apws/261108-retro-comp-andrew-codex-kicad/schematics/02-wired-a3/README.adoc

= Separate wired A3 schematic
:title: {docname}

Open link:Z80_Simple_Computer.kicad_pro[the KiCad project] or link:../../output/pdf/Z80_Simple_Computer-wired-A3.pdf[the A3 PDF]. This is a separate single-sheet drawing of the checked circuit, with no PCB changes. The original label-oriented schematic remains authoritative in `design/`.

The address/data buses have 95 member entries. All 55 remaining scalar signal nets have continuous drawn paths; power uses standard supply symbols and wired local rails. See link:../../docs/261109-1528-SCHEMATIC-wired-A3.adoc[the handover and reproduction instructions].

The initial variant was generated by `tools/build_wired_schematic.py` and committed as `1184700`. Falken then refined it in KiCad. The current file is a verified *human-edited* schematic; continue editing this file directly. The generator retains its original output hash and refuses to overwrite the human edits. The layout snapshot synchronizer does not replace this separate drawing.

See link:../../docs/261109-1549-REVIEW-human-schematic-corrections.adoc[the human-corrections review and minimal wiring repairs]. After fresh native netlist/ERC exports, `tools/check_wired_schematic.py` rechecks the reviewed version. Its `--accept-manual` option records a newly edited version only after the connectivity, drawn-path and unchanged-rule checks pass.
