apws/261108-retro-comp-andrew-codex-kicad/reports/routing/03-kicad-interactive/route-worksheet.csv

group | net | reference | pad | x_mm | y_mm
group1 | /CLK | Y1 | 8 | 42.62 | 10.19
group1 | /CLK | U1 | 6 | 68.575 | 29.62
group1 | /CLK_UART | U5 | 16 | 51.025 | 41.38
group1 | /CLK_UART | Y2 | 5 | 41.81 | 25.19
group1 | /~{RESET} | U7 | 4 | 100.195 | 49.0
group1 | /~{RESET} | U1 | 26 | 91.435 | 14.38
group1 | /SW_RESET | R2 | 2 | 22.08 | 82.0
group1 | /SW_RESET | SW1 | 1 | 16.75 | 87.75
group1 | /SW_RESET | SW1 | 1 | 23.25 | 87.75
group1 | /RESET_RC | R2 | 1 | 11.92 | 82.0
group1 | /RESET_RC | C1 | 1 | 28.7487 | 78.0
group1 | /RESET_RC | R1 | 2 | 20.08 | 77.0
group1 | /RESET_RC | U7 | 1 | 100.195 | 41.38
group1 | /RESET_H | U5 | 35 | 76.425 | 56.62
group1 | /RESET_H | U7 | 2 | 100.195 | 43.92
group1 | /RESET_H | U7 | 3 | 100.195 | 46.46
group1 | /RESET_H | U4 | 35 | 68.575 | 70.38
group2 | /C1P | U6 | 1 | 23.805 | 58.89
group2 | /C1P | C20 | 1 | 28.7487 | 58.0
group2 | /C1M | U6 | 3 | 23.805 | 53.81
group2 | /C1M | C20 | 2 | 31.2487 | 58.0
group2 | /C2P | U6 | 4 | 23.805 | 51.27
group2 | /C2P | C21 | 1 | 28.7487 | 50.0
group2 | /C2M | U6 | 5 | 23.805 | 48.73
group2 | /C2M | C21 | 2 | 31.2487 | 50.0
group2 | /VS_MINUS | U6 | 6 | 23.805 | 46.19
group2 | /VS_MINUS | C24 | 2 | 28.7487 | 42.0
group2 | /VS_PLUS | U6 | 2 | 23.805 | 56.35
group2 | /VS_PLUS | C23 | 1 | 28.7487 | 66.0
group2 | /DSR_RS232 | J1 | 6 | 4.94 | 54.155
group2 | /DSR_RS232 | U6 | 8 | 23.805 | 41.11
group2 | /DTR_RS232 | J1 | 4 | 7.78 | 47.23
group2 | /DTR_RS232 | U6 | 7 | 23.805 | 43.65
group2 | /RX_RS232 | J1 | 2 | 7.78 | 52.77
group2 | /RX_RS232 | U6 | 13 | 16.185 | 51.27
group2 | /TX_RS232 | J1 | 3 | 7.78 | 50.0
group2 | /TX_RS232 | U6 | 14 | 16.185 | 53.81
group2 | /TX_TTL | U5 | 11 | 63.725 | 41.38
group2 | /TX_TTL | U6 | 11 | 16.185 | 46.19
group2 | /RX_TTL | U5 | 10 | 66.265 | 41.38
group2 | /RX_TTL | U6 | 12 | 16.185 | 48.73
group2 | /DTR_TTL | U5 | 33 | 71.345 | 56.62
group2 | /DTR_TTL | U6 | 10 | 16.185 | 43.65
group2 | /DSR_TTL | U5 | 37 | 81.505 | 56.62
group2 | /DSR_TTL | U6 | 9 | 16.185 | 41.11
group3 | /D0 | U5 | 1 | 89.125 | 41.38
group3 | /D0 | U4 | 34 | 71.115 | 70.38
group3 | /D0 | U1 | 14 | 88.895 | 29.62
group3 | /D0 | U2 | 11 | 138.89 | 56.62
group3 | /D0 | U3 | 11 | 138.89 | 29.62
group3 | /D1 | U5 | 2 | 86.585 | 41.38
group3 | /D1 | U4 | 33 | 73.655 | 70.38
group3 | /D1 | U1 | 15 | 91.435 | 29.62
group3 | /D1 | U2 | 12 | 141.43 | 56.62
group3 | /D1 | U3 | 12 | 141.43 | 29.62
group3 | /D2 | U5 | 3 | 84.045 | 41.38
group3 | /D2 | U4 | 32 | 76.195 | 70.38
group3 | /D2 | U1 | 12 | 83.815 | 29.62
group3 | /D2 | U2 | 13 | 143.97 | 56.62
group3 | /D2 | U3 | 13 | 143.97 | 29.62
group3 | /D3 | U5 | 4 | 81.505 | 41.38
group3 | /D3 | U4 | 31 | 78.735 | 70.38
group3 | /D3 | U1 | 8 | 73.655 | 29.62
group3 | /D3 | U2 | 15 | 146.51 | 41.38
group3 | /D3 | U3 | 15 | 146.51 | 14.38
group3 | /D4 | U5 | 5 | 78.965 | 41.38
group3 | /D4 | U4 | 30 | 81.275 | 70.38
group3 | /D4 | U1 | 7 | 71.115 | 29.62
group3 | /D4 | U2 | 16 | 143.97 | 41.38
group3 | /D4 | U3 | 16 | 143.97 | 14.38
group3 | /D5 | U5 | 6 | 76.425 | 41.38
group3 | /D5 | U4 | 29 | 83.815 | 70.38
group3 | /D5 | U1 | 9 | 76.195 | 29.62
group3 | /D5 | U2 | 17 | 141.43 | 41.38
group3 | /D5 | U3 | 17 | 141.43 | 14.38
group3 | /D6 | U5 | 7 | 73.885 | 41.38
group3 | /D6 | U4 | 28 | 86.355 | 70.38
group3 | /D6 | U1 | 10 | 78.735 | 29.62
group3 | /D6 | U2 | 18 | 138.89 | 41.38
group3 | /D6 | U3 | 18 | 138.89 | 14.38
group3 | /D7 | U5 | 8 | 71.345 | 41.38
group3 | /D7 | U4 | 27 | 88.895 | 70.38
group3 | /D7 | U1 | 13 | 86.355 | 29.62
group3 | /D7 | U2 | 19 | 136.35 | 41.38
group3 | /D7 | U3 | 19 | 136.35 | 14.38
group4 | /~{A15} | U7 | 8 | 107.815 | 56.62
group4 | /~{A15} | U8 | 13 | 122.815 | 72.92
group4 | /~{A7} | U7 | 6 | 100.195 | 54.08
group4 | /~{A7} | U8 | 5 | 115.195 | 80.54
group4 | /~{PIOCS} | U4 | 6 | 68.575 | 85.62
group4 | /~{PIOCS} | U8 | 3 | 115.195 | 75.46
group4 | /~{ROMCS} | U3 | 20 | 133.81 | 14.38
group4 | /~{ROMCS} | U8 | 8 | 122.815 | 85.62
group4 | /~{RAMCS} | U2 | 20 | 133.81 | 41.38
group4 | /~{RAMCS} | U8 | 11 | 122.815 | 78.0
group4 | /~{UARTCS} | U5 | 14 | 56.105 | 41.38
group4 | /~{UARTCS} | U8 | 6 | 115.195 | 83.08
group4 | /A0 | U5 | 28 | 58.645 | 56.62
group4 | /A0 | U4 | 9 | 76.195 | 85.62
group4 | /A0 | U1 | 30 | 81.275 | 14.38
group4 | /A0 | U2 | 10 | 136.35 | 56.62
group4 | /A0 | U3 | 10 | 136.35 | 29.62
group4 | /A1 | U5 | 27 | 56.105 | 56.62
group4 | /A1 | U4 | 8 | 73.655 | 85.62
group4 | /A1 | U1 | 31 | 78.735 | 14.38
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
group7 | /PC4 | U4 | 13 | 86.355 | 85.62
group7 | /PC4 | J4 | 5 | 82.27 | 94.0
group7 | /PC5 | U4 | 12 | 83.815 | 85.62
group7 | /PC5 | J4 | 6 | 84.81 | 94.0
group7 | /PC6 | U4 | 11 | 81.275 | 85.62
group7 | /PC6 | J4 | 7 | 87.35 | 94.0
group7 | /PC7 | U4 | 10 | 78.735 | 85.62
group7 | /PC7 | J4 | 8 | 89.89 | 94.0
