apws/261108-retro-comp-andrew-codex-kicad/output/firstz80/01-manhattan/placement.png

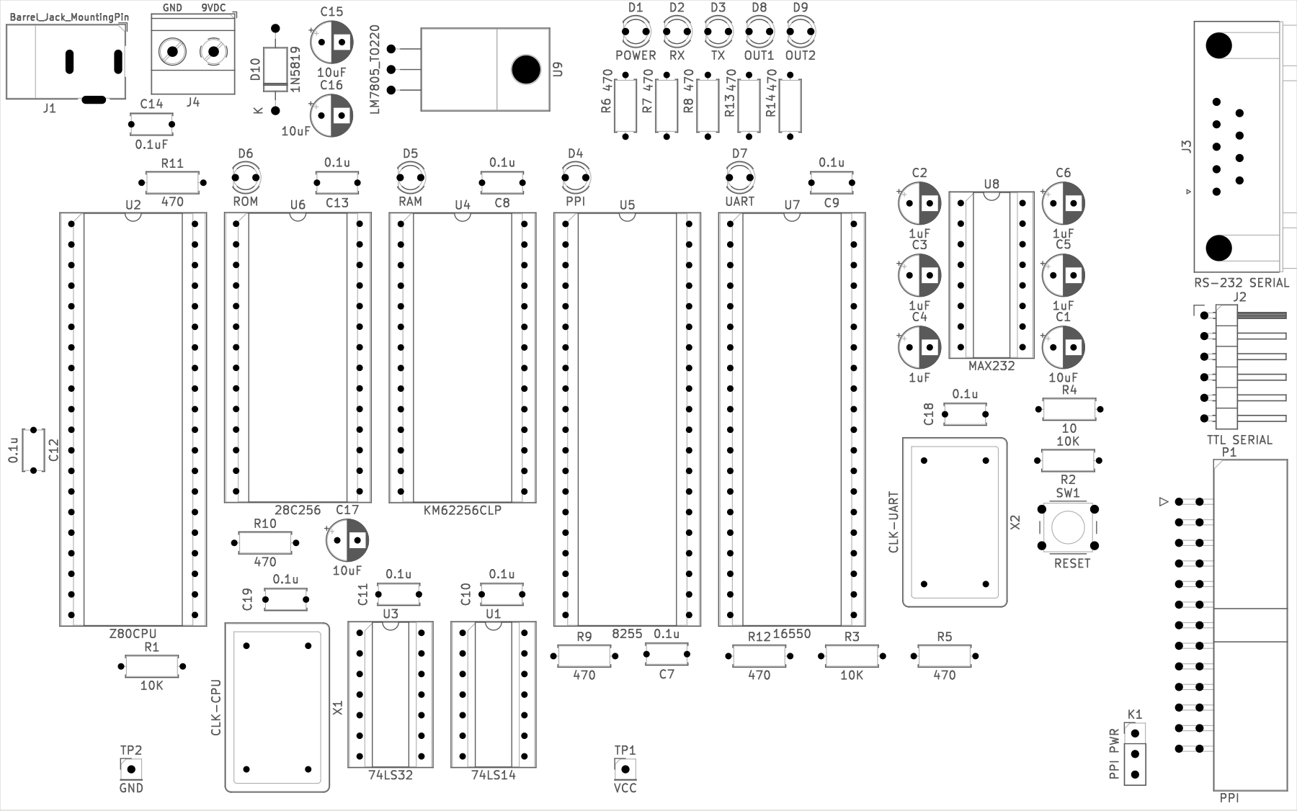
output/firstz80/01-manhattan/placement.png
