apws/261108-retro-comp-andrew-codex-kicad/output/firstz80/03-freerouting/signals.png

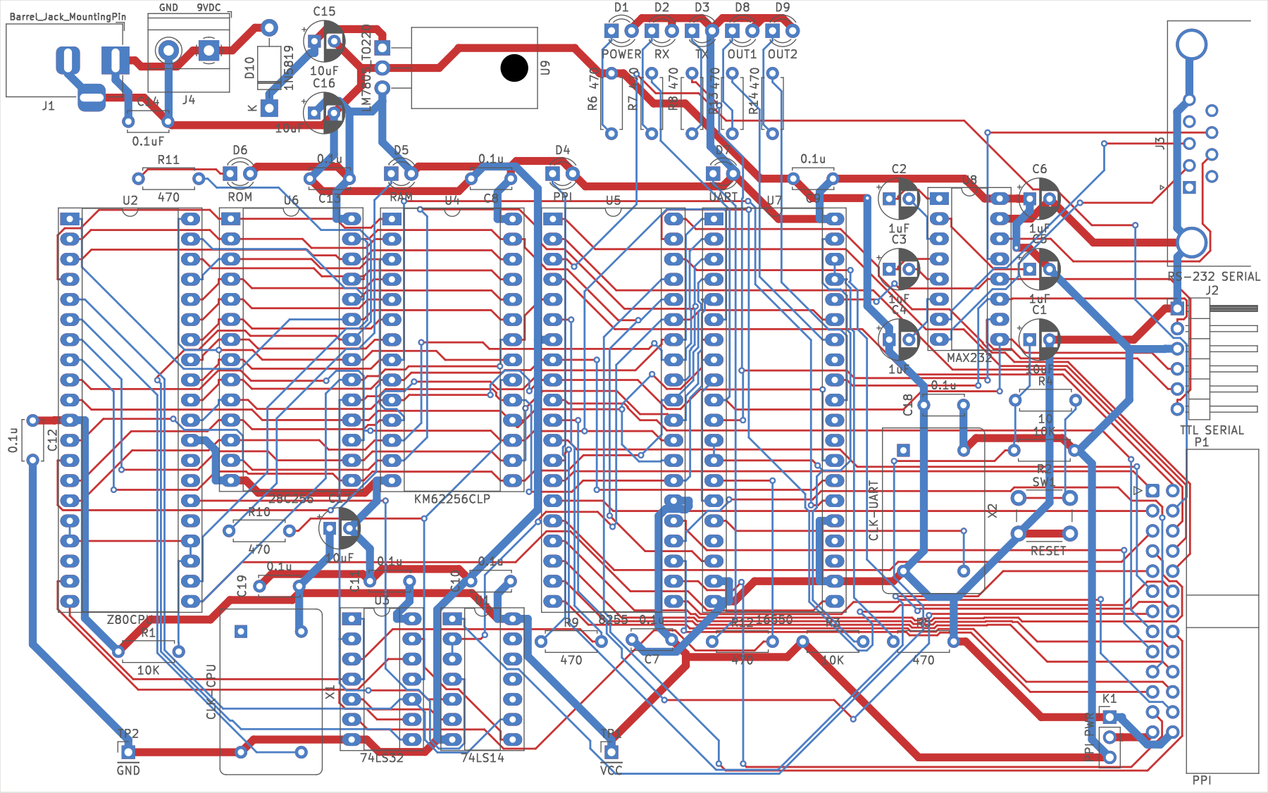
output/firstz80/03-freerouting/signals.png
