apws/261108-retro-comp-andrew-codex-kicad/output/firstz80/03-freerouting/top.png

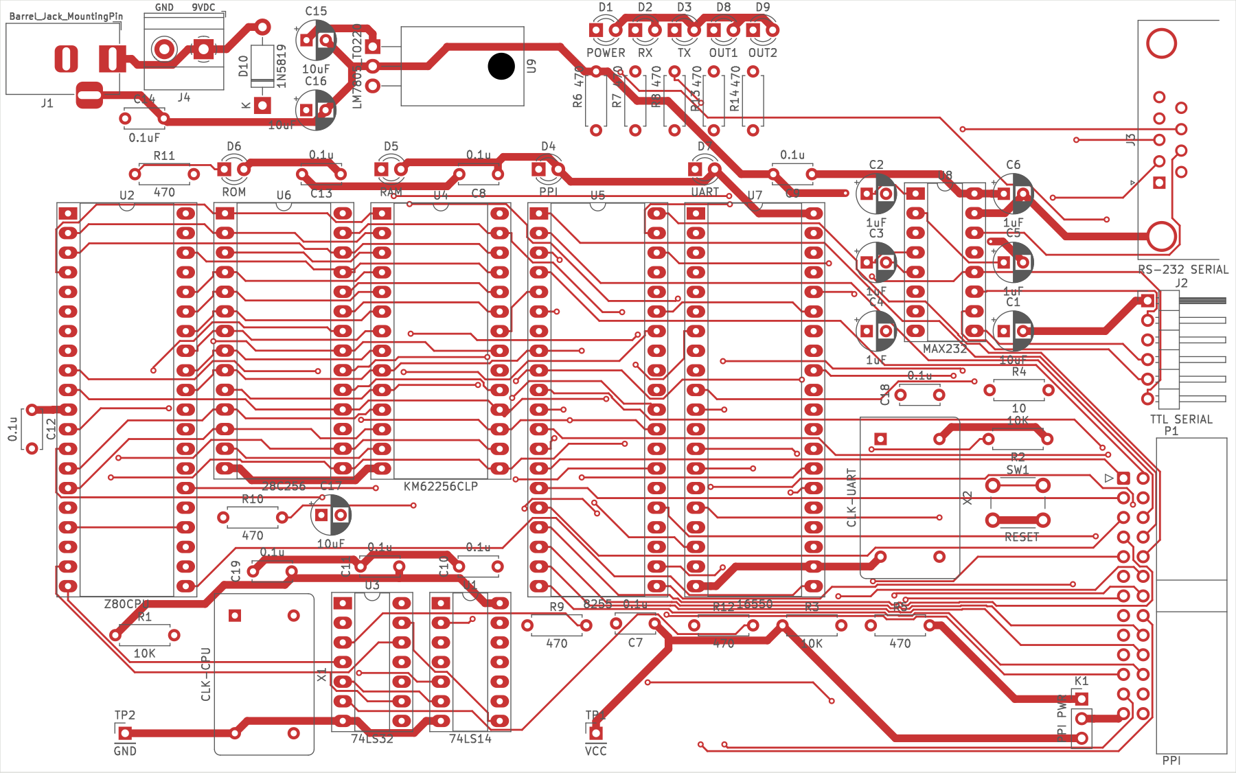
output/firstz80/03-freerouting/top.png
