apws/261108-retro-comp-andrew-codex-kicad/output/firstz80/comparison.png

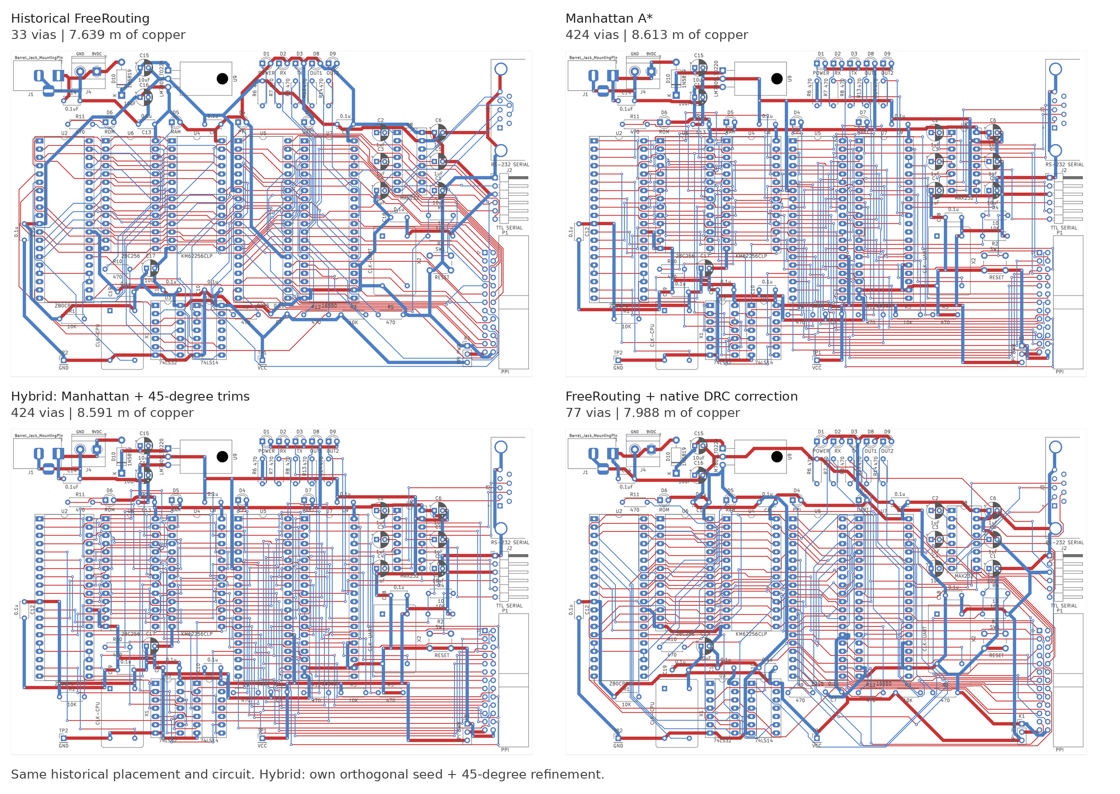
output/firstz80/comparison.png
