apws/261108-retro-comp-andrew-codex-kicad/output/firstz80/octilinear-corner-detail.png

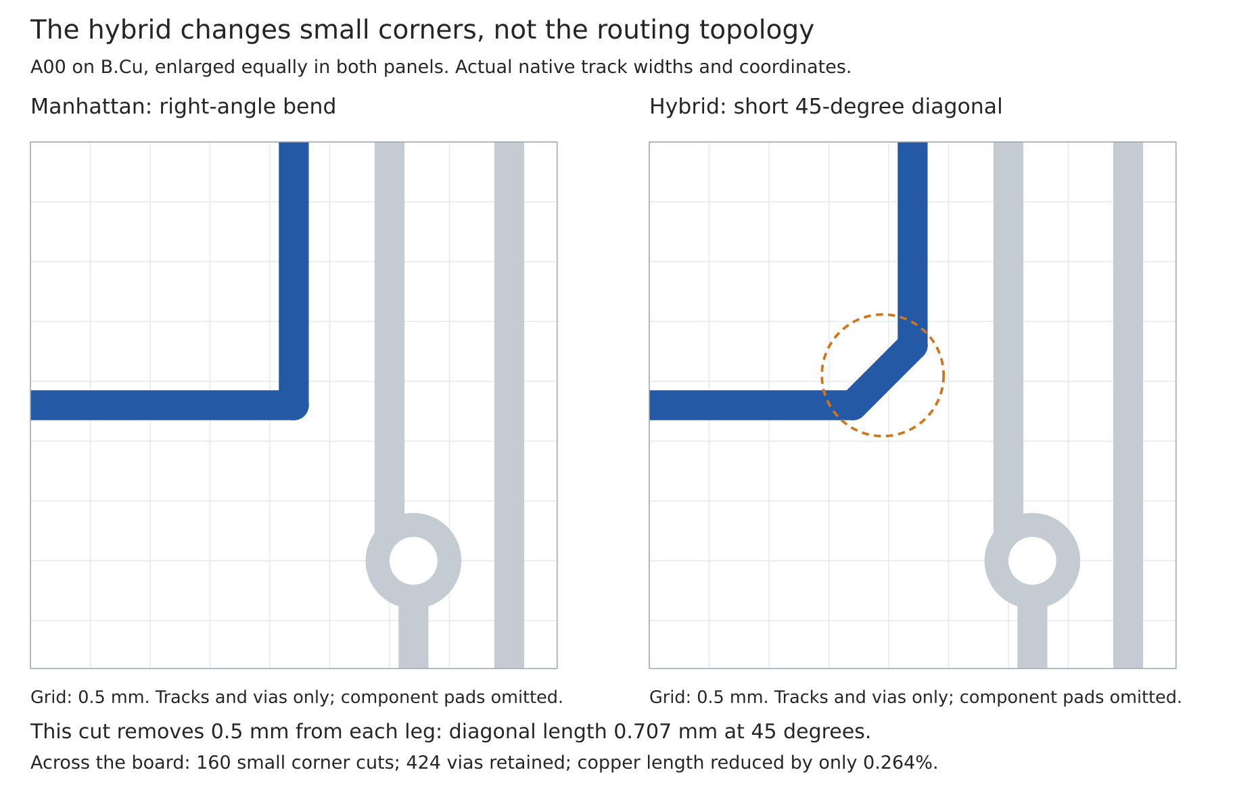
output/firstz80/octilinear-corner-detail.png
