apws/261108-retro-comp-andrew-codex-kicad/output/firstz80/reference-normalized/bottom.png

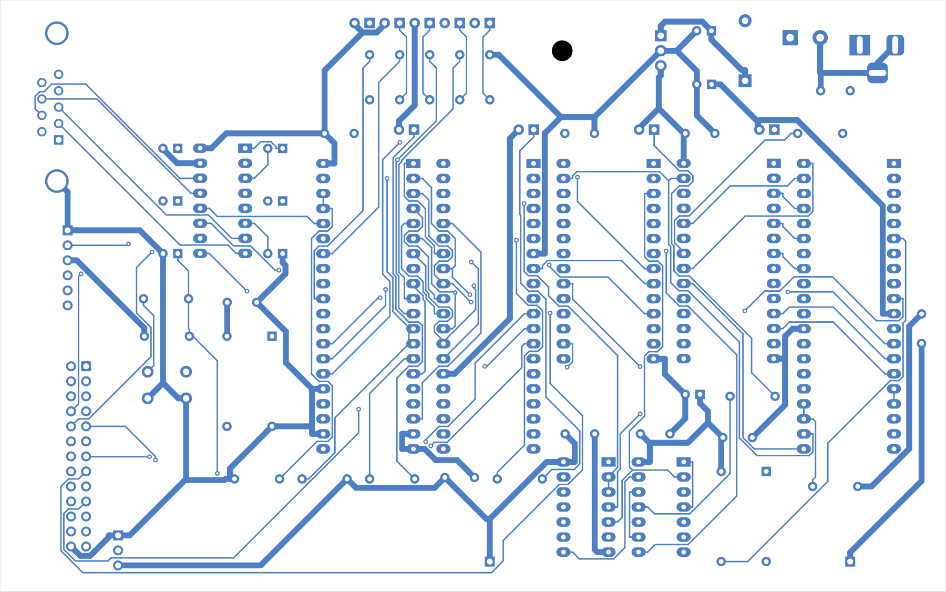
output/firstz80/reference-normalized/bottom.png
