apws/261108-retro-comp-andrew-codex-kicad/output/routing/01-reused-agy-router/top.png

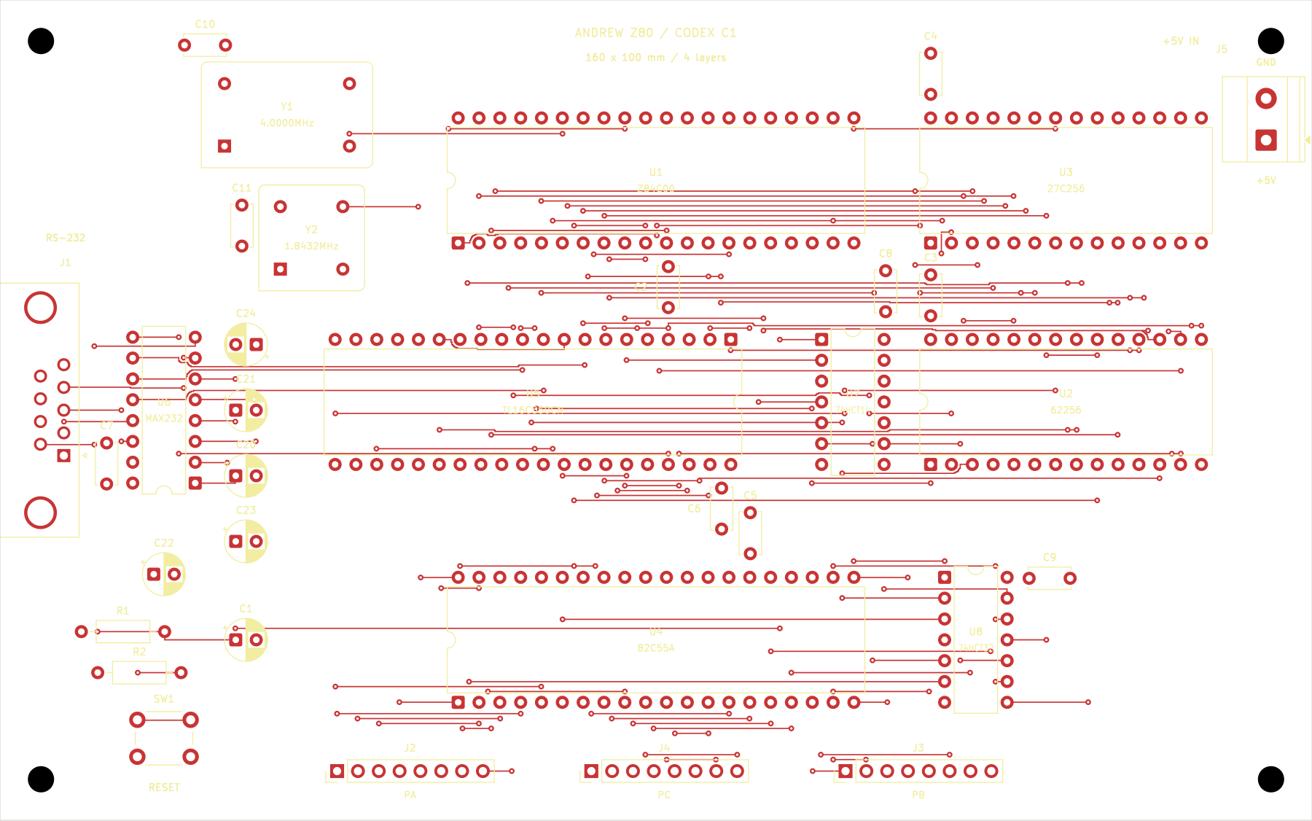
output/routing/01-reused-agy-router/top.png
