apws/261108-retro-comp-andrew-codex-kicad/output/routing/02-codex-router/bottom.png

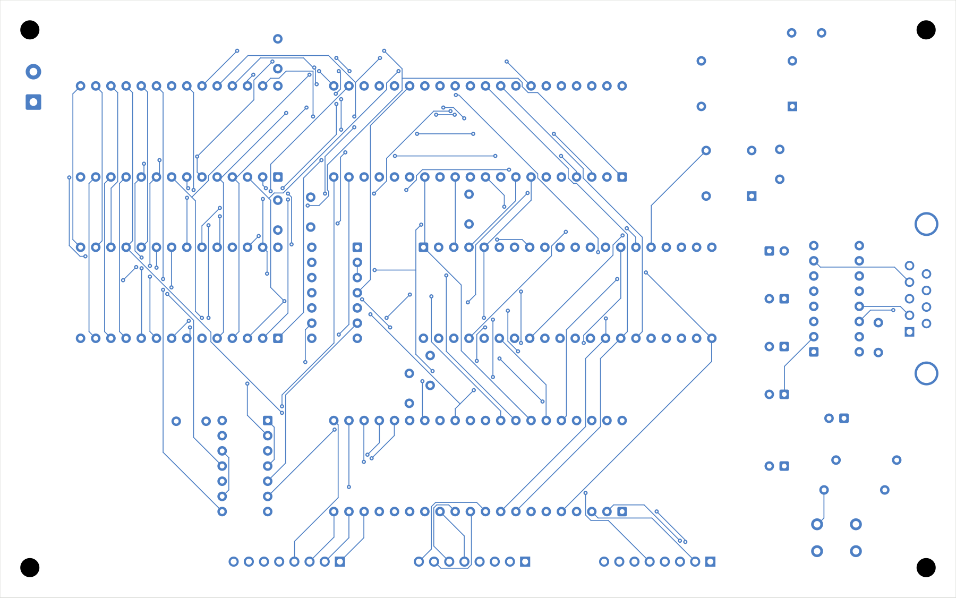
output/routing/02-codex-router/bottom.png
