apws/261108-retro-comp-andrew-codex-kicad/output/routing/02-codex-router/planes.png

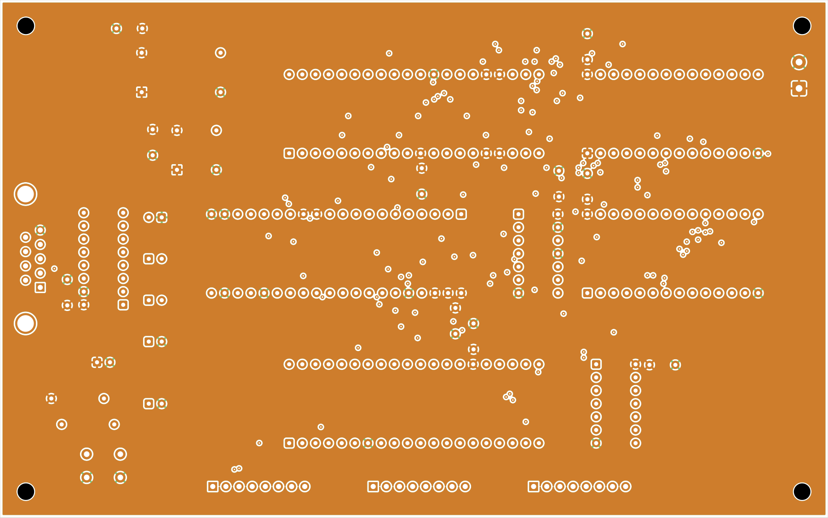
output/routing/02-codex-router/planes.png
