apws/261108-retro-comp-andrew-codex-kicad/output/routing/04-freerouting/bottom.png

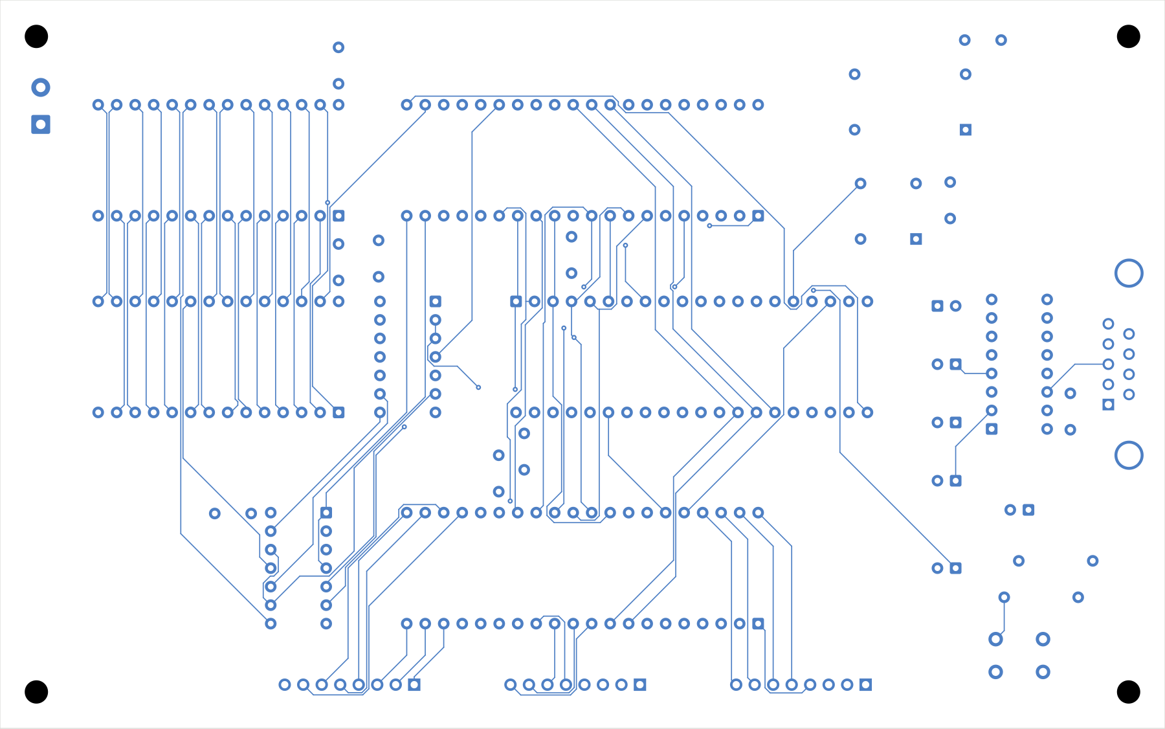
output/routing/04-freerouting/bottom.png
