apws/261108-retro-comp-andrew-codex-kicad/output/routing/04-freerouting/top.png

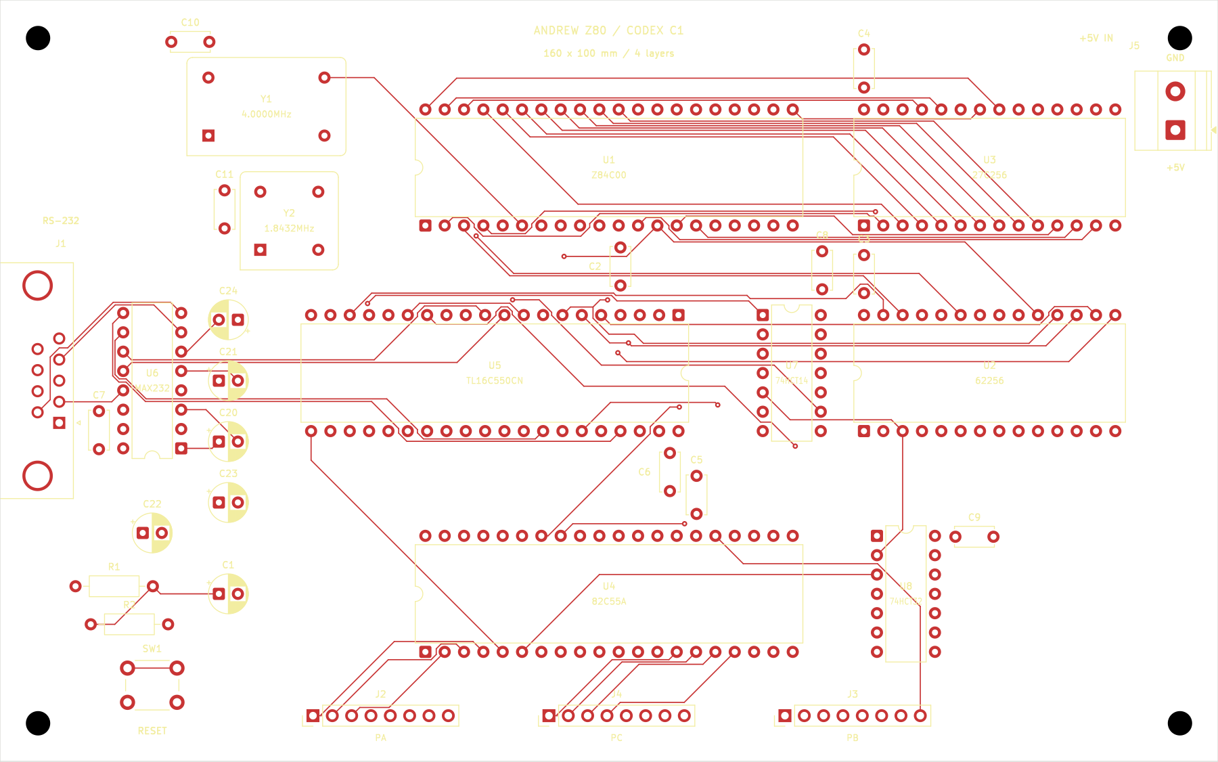
output/routing/04-freerouting/top.png
