apws/261108-retro-comp-andrew-codex-kicad/output/schematic-7805/schematic-7805.png

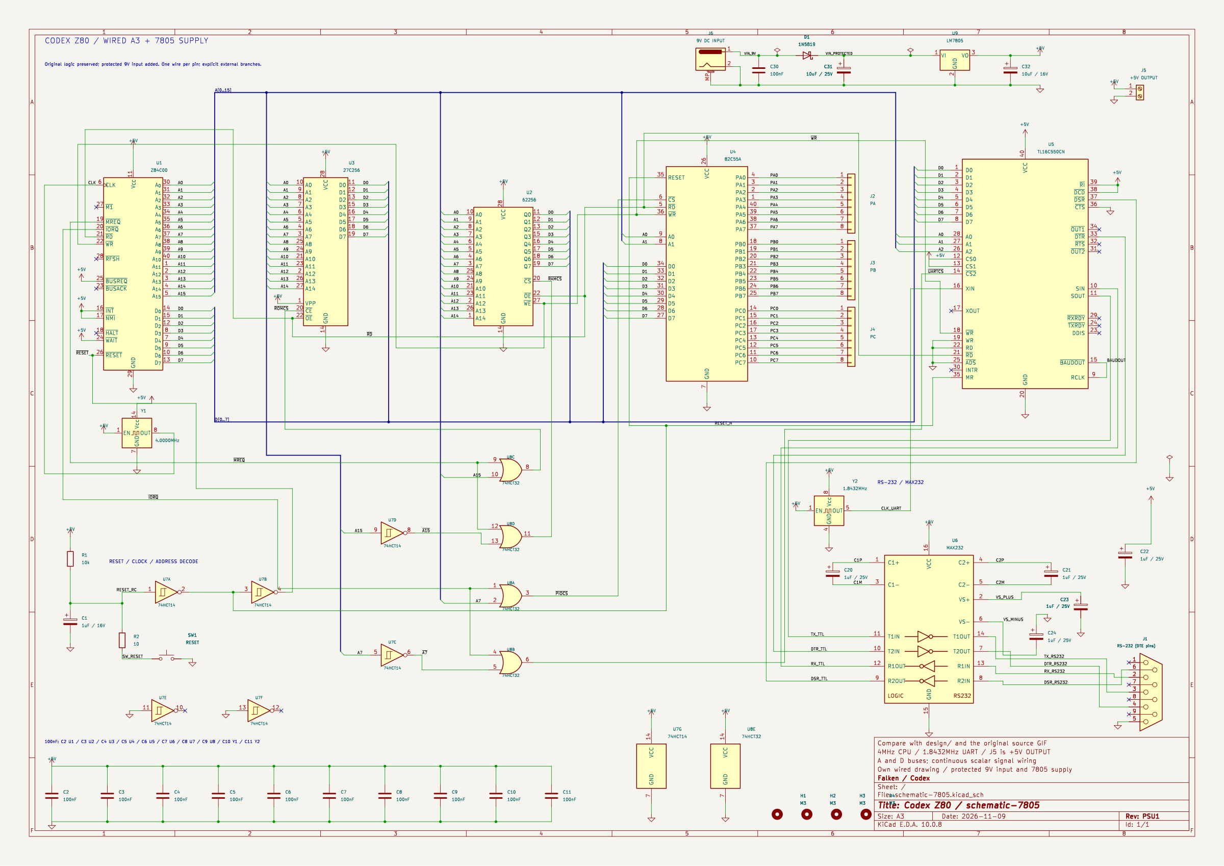
output/schematic-7805/schematic-7805.png
