apws/261108-retro-comp-andrew-codex-kicad/reference/grok-agy/docs/images/261103-2328 first schematic -- Screenshot_20261103_232820.png

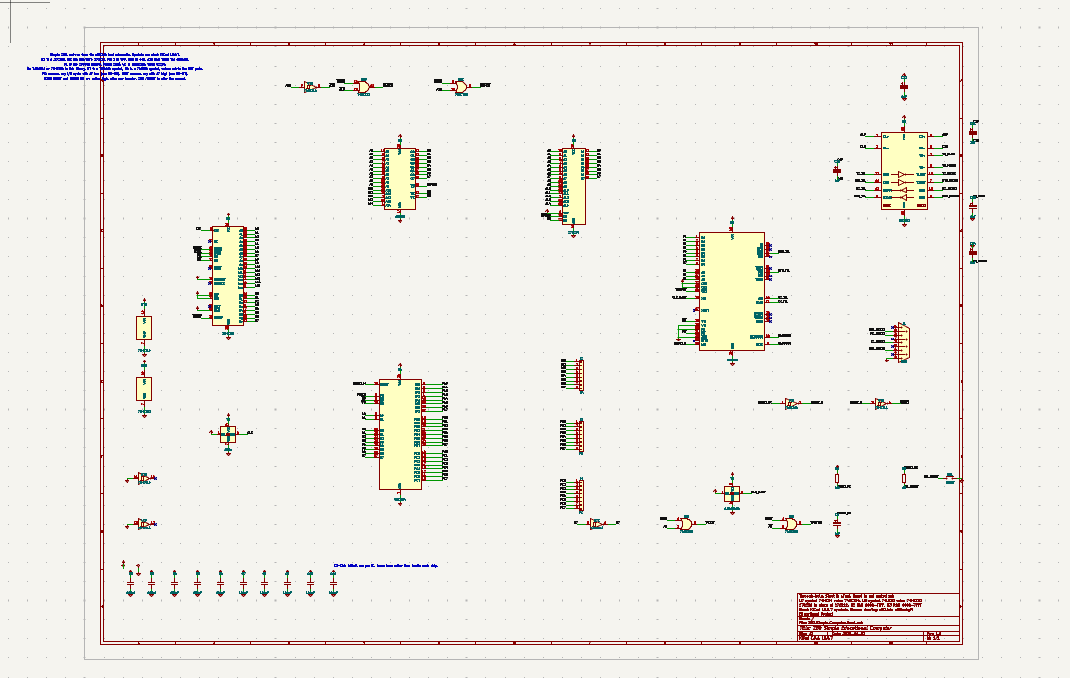
reference/grok-agy/docs/images/261103-2328 first schematic -- Screenshot_20261103_232820.png
