apws/261108-retro-comp-andrew-codex-kicad/reference/grok-agy/docs/images/261104-0004 very hard for grok only to relayout the sheet QQQ -- Screenshot_20261104_000429.png

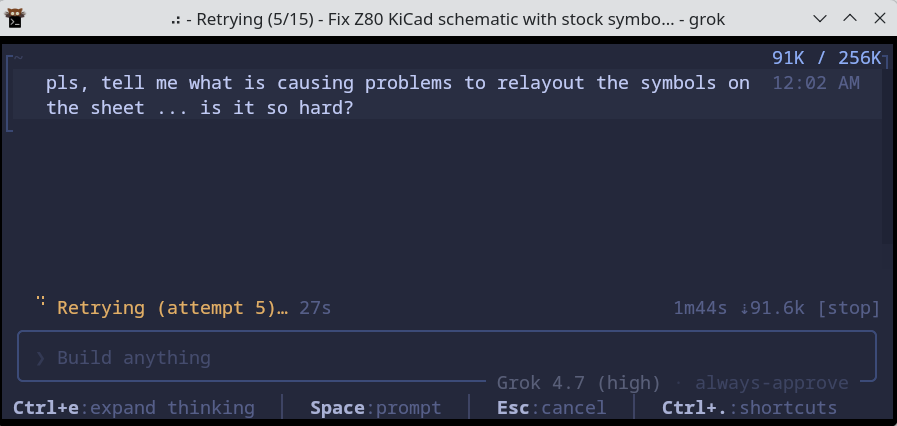
reference/grok-agy/docs/images/261104-0004 very hard for grok only to relayout the sheet QQQ -- Screenshot_20261104_000429.png
