apws/261108-retro-comp-andrew-codex-kicad/reference/grok-agy/docs/images/261104-0042 schematic relayout, but still large A2 sheet QQ -- Screenshot_20261104_004217.png

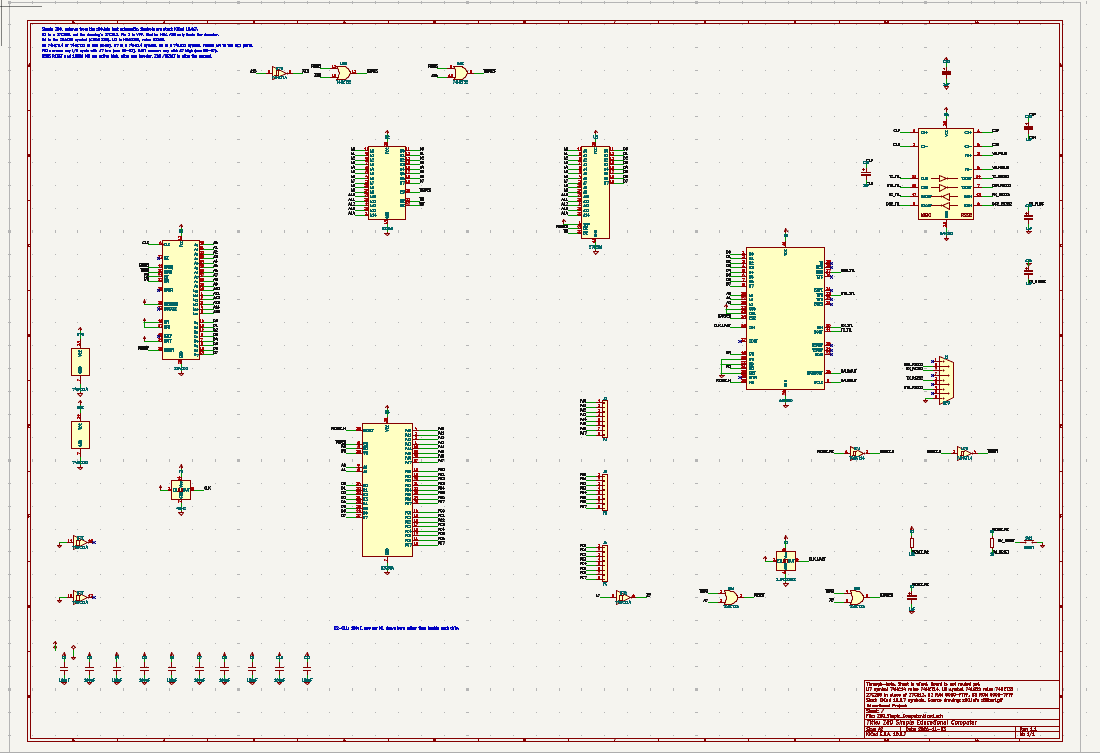
reference/grok-agy/docs/images/261104-0042 schematic relayout, but still large A2 sheet QQ -- Screenshot_20261104_004217.png
