apws/261108-retro-comp-andrew-codex-kicad/reference/grok-agy/docs/images/261105-00 implementing the placement and routing plan, it started but - out of weekly limit.png

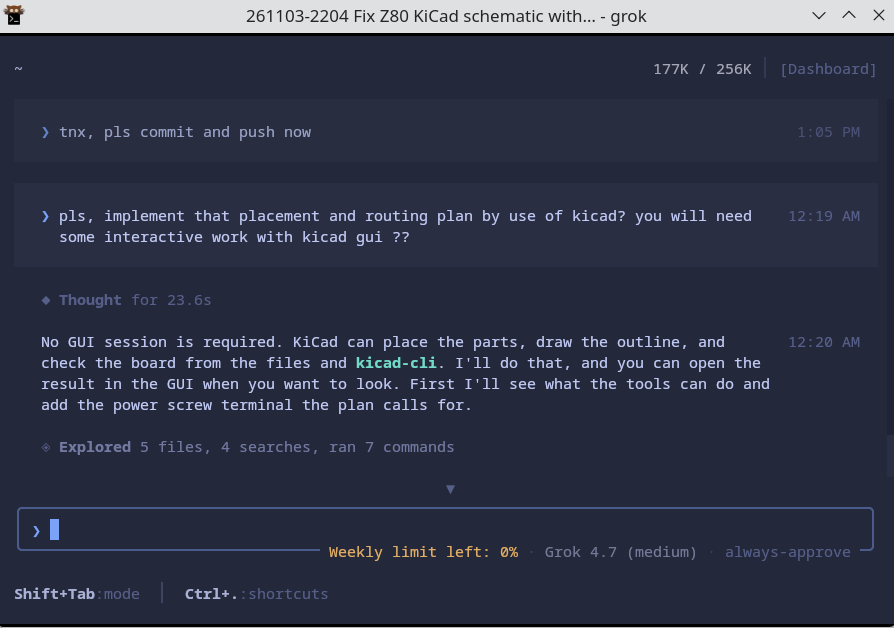
reference/grok-agy/docs/images/261105-00 implementing the placement and routing plan, it started but - out of weekly limit.png
