apws/261108-retro-comp-andrew-codex-kicad/reference/grok-agy/docs/images/261105-01 tell the agent - use tscircuit - Screenshot_20261105_011434.png

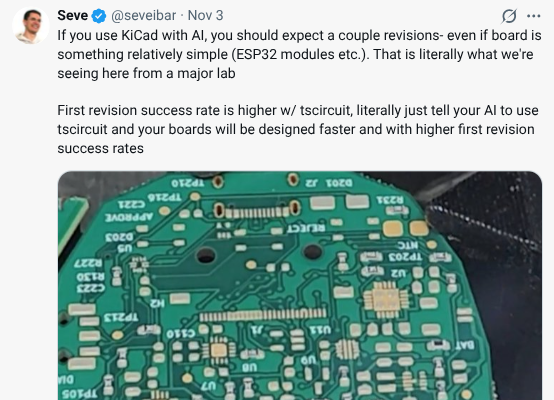
reference/grok-agy/docs/images/261105-01 tell the agent - use tscircuit - Screenshot_20261105_011434.png
