apws/261108-retro-comp-andrew-codex-kicad/reference/grok-agy/docs/images/261106-03 grok 2nd placement and 3d models in -- Screenshot_20261106_030632.png

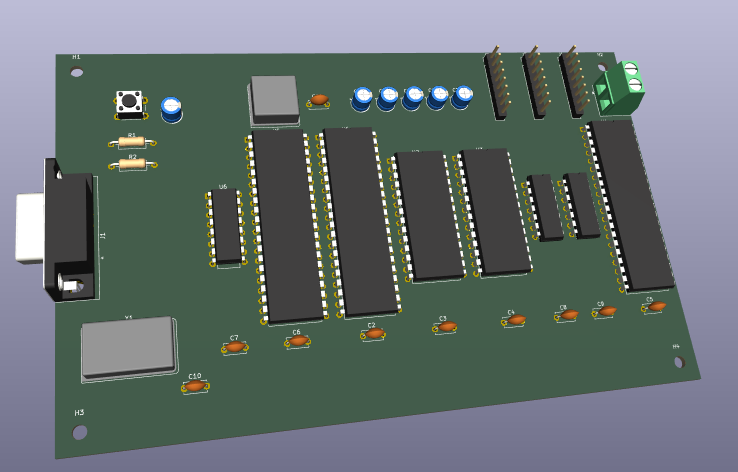
reference/grok-agy/docs/images/261106-03 grok 2nd placement and 3d models in -- Screenshot_20261106_030632.png
