apws/261108-retro-comp-andrew-codex-kicad/reference/grok-agy/docs/images/261106-18a google agy lauch, auth (free on google-android account QQ) -- Screenshot_20261106_190007.png

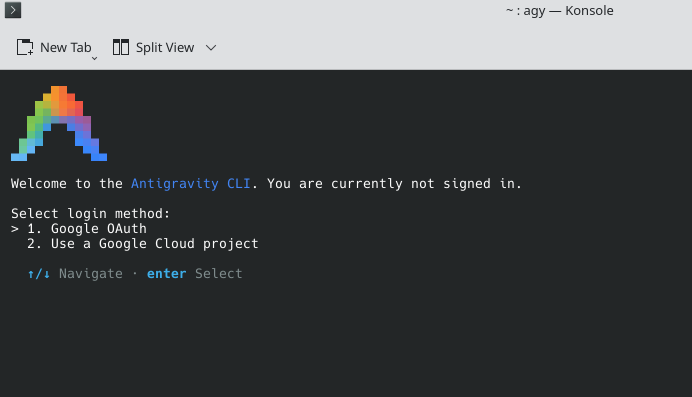
reference/grok-agy/docs/images/261106-18a google agy lauch, auth (free on google-android account QQ) -- Screenshot_20261106_190007.png
