apws/261108-retro-comp-andrew-codex-kicad/reference/grok-agy/docs/images/261106-18b google agy logged in -- Screenshot_20261106_190125.png

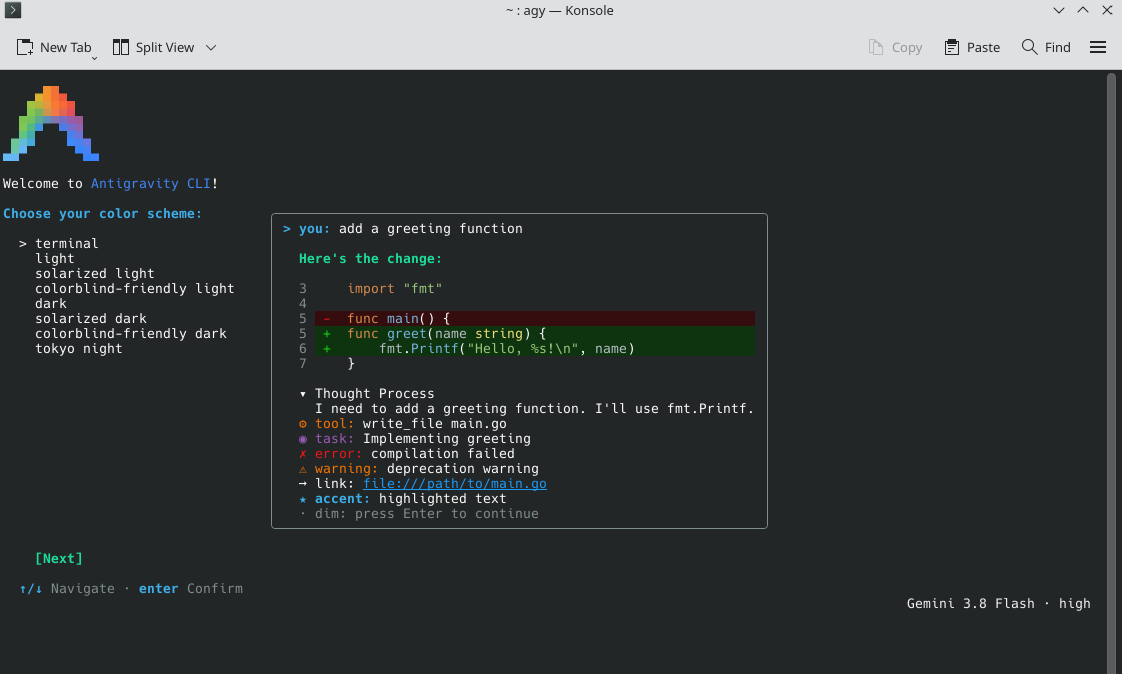
reference/grok-agy/docs/images/261106-18b google agy logged in -- Screenshot_20261106_190125.png
