apws/261108-retro-comp-andrew-codex-kicad/reference/grok-agy/docs/images/261106-18c google agy logged in - next config  -- Screenshot_20261106_190250.png

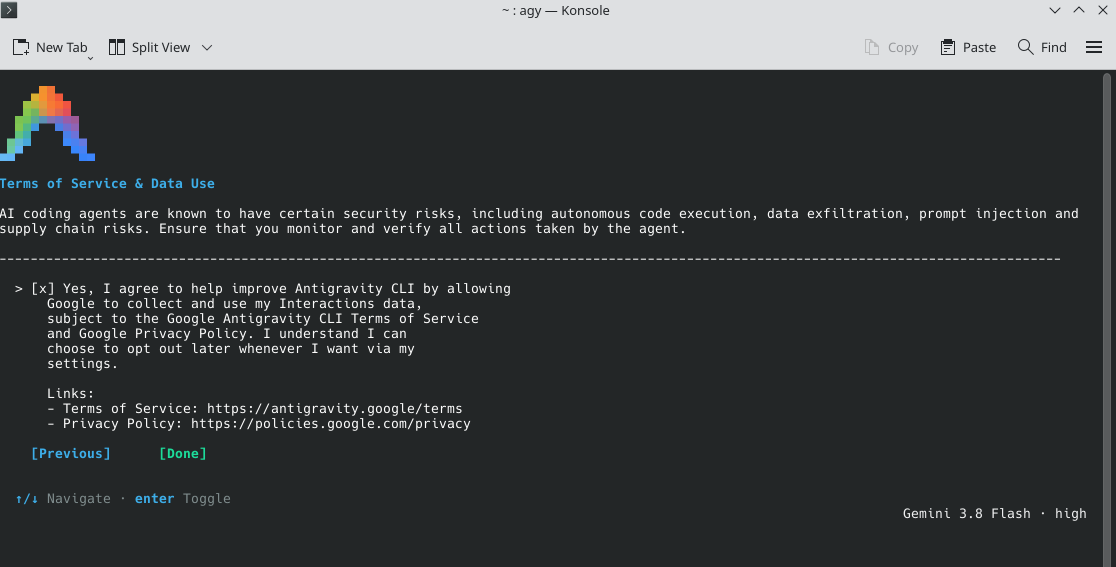
reference/grok-agy/docs/images/261106-18c google agy logged in - next config -- Screenshot_20261106_190250.png
