apws/261108-retro-comp-andrew-codex-kicad/reference/grok-agy/docs/images/261106-22b google agy - manhattan strict router weird stairs but DRC 100percent OK -- Screenshot_20261106_215736.png

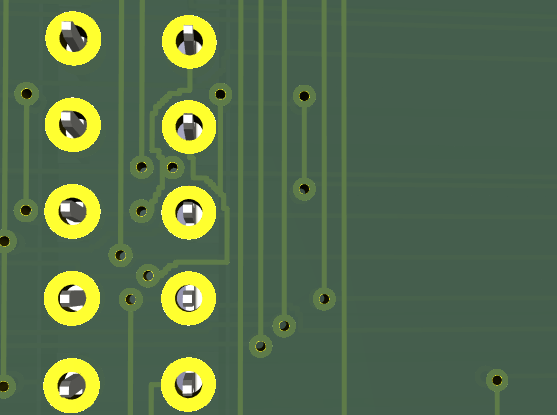
reference/grok-agy/docs/images/261106-22b google agy - manhattan strict router weird stairs but DRC 100percent OK -- Screenshot_20261106_215736.png
