apws/261108-retro-comp-andrew-codex-kicad/reference/grok-agy/docs/images/!! feilipu cpm-ide ek 8085+acia -- Screenshot_20261103_222529.png

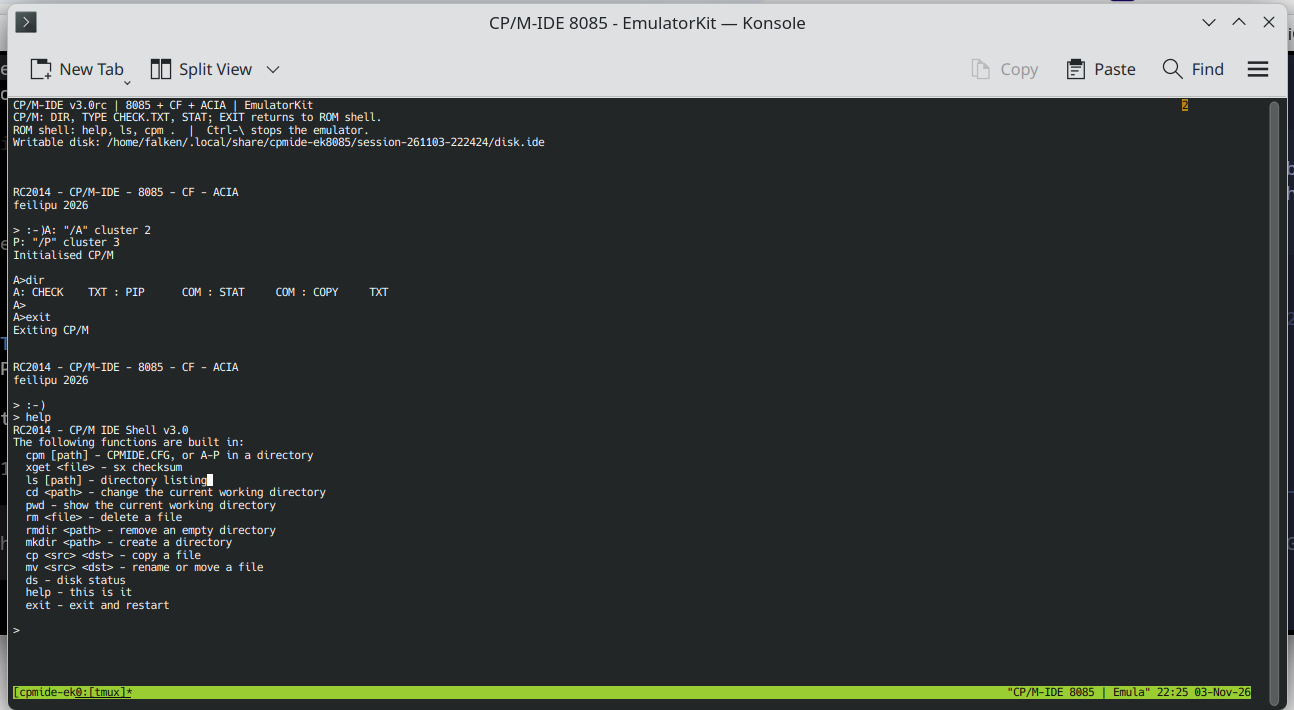
reference/grok-agy/docs/images/!! feilipu cpm-ide ek 8085+acia -- Screenshot_20261103_222529.png
