apws/261108-retro-comp-andrew-codex-kicad/reference/grok-agy/docs/images/!!! feilipu 8085 using EK + andrew kicad in grok - Screenshot_20261103_222328.png

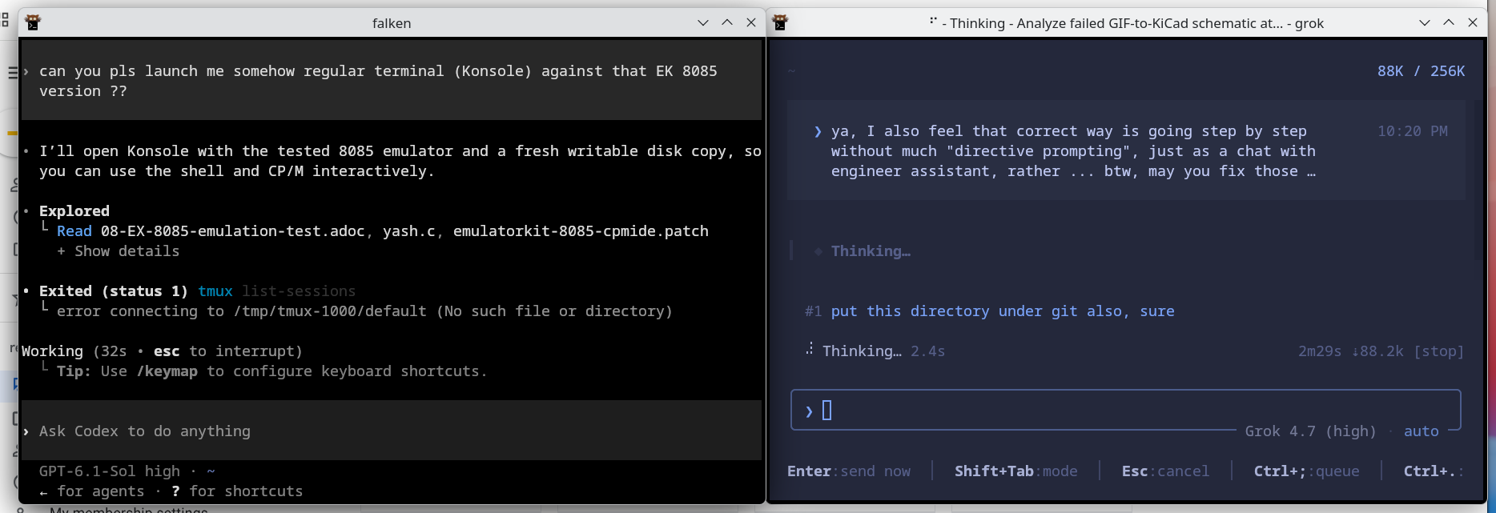
reference/grok-agy/docs/images/!!! feilipu 8085 using EK + andrew kicad in grok - Screenshot_20261103_222328.png
