apws/261108-retro-comp-andrew-codex-kicad/reference/grok-agy/docs/images/!!! grok in kitty, authorized by web over X -- Screenshot_20261103_220742.png

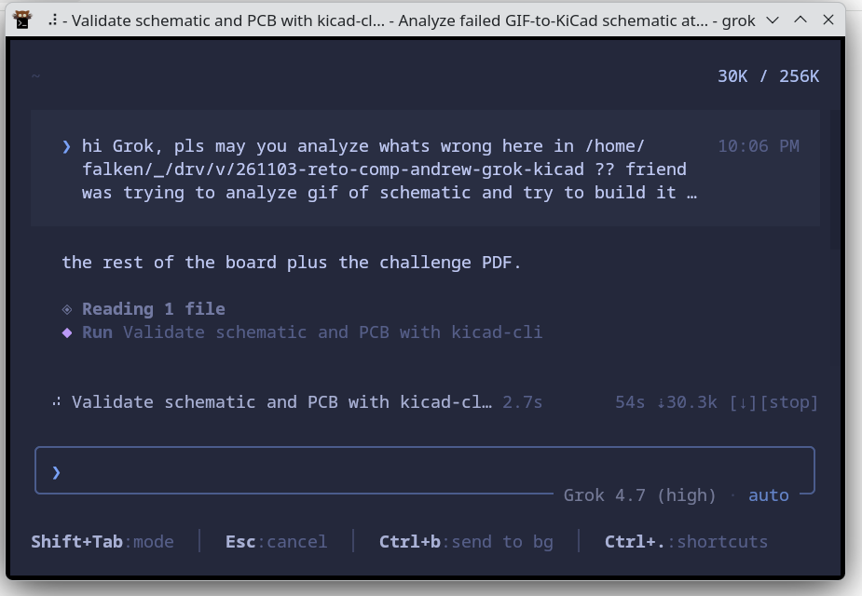
reference/grok-agy/docs/images/!!! grok in kitty, authorized by web over X -- Screenshot_20261103_220742.png
