apws/261108-retro-comp-andrew-codex-kicad/reference/source/simple-homebrew-computer-for-beginners-v0-qpm8wzdsoodc1.webp

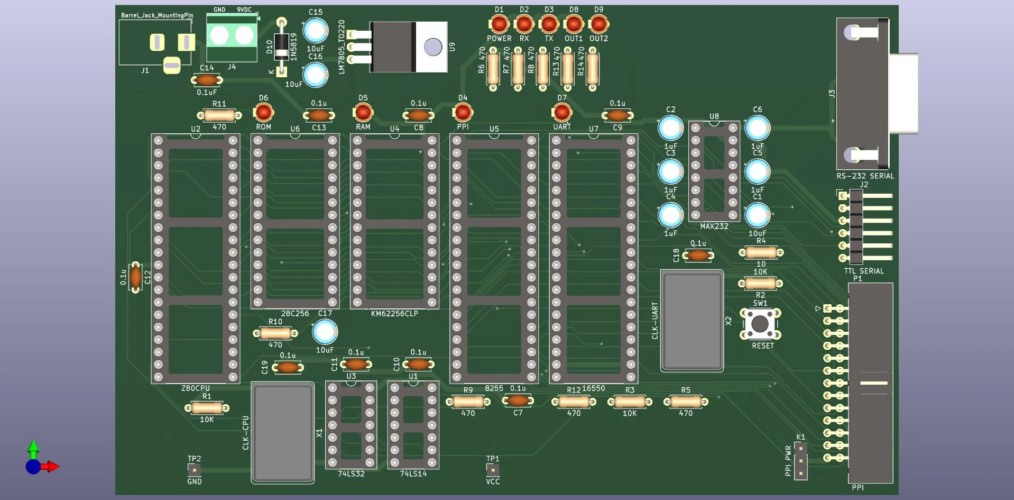
reference/source/simple-homebrew-computer-for-beginners-v0-qpm8wzdsoodc1.webp
