apws/261108-retro-comp-andrew-codex-kicad/reports/schematic-wired-a3/mark-review-261109-2306/max232.png

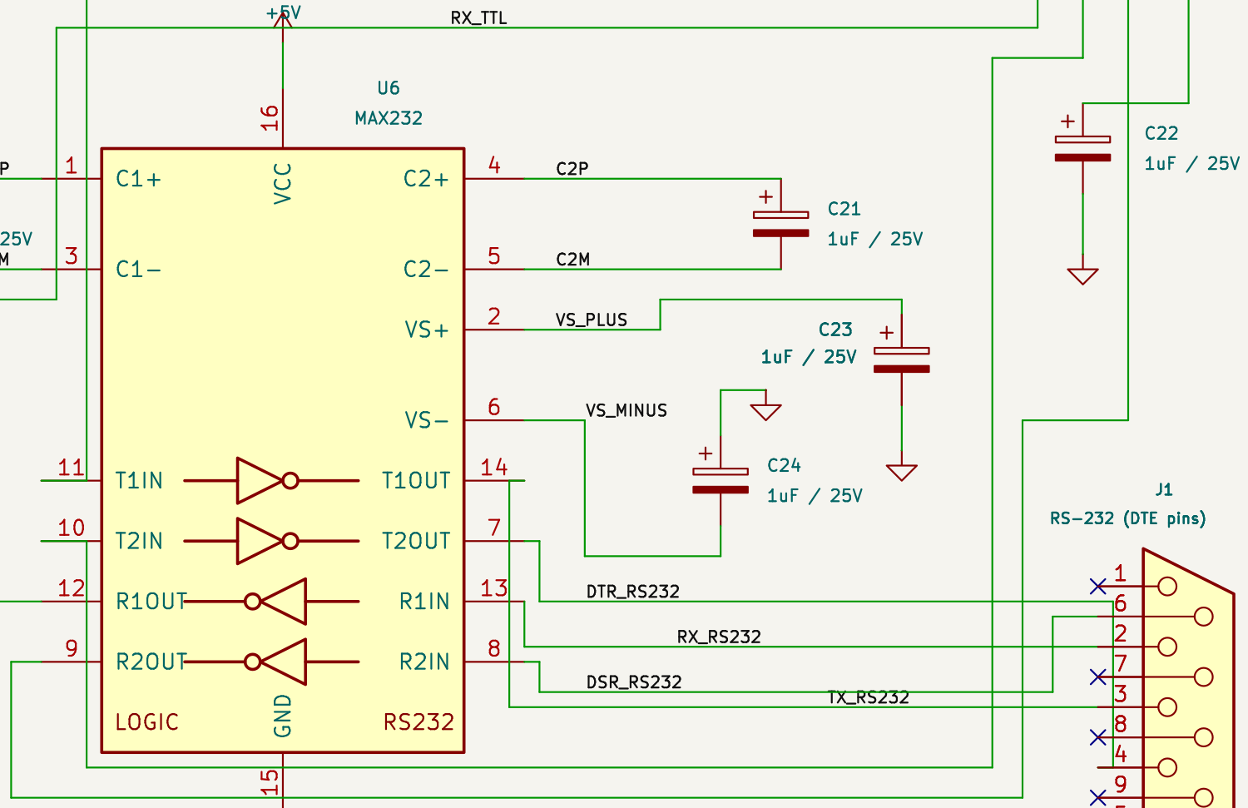
reports/schematic-wired-a3/mark-review-261109-2306/max232.png
