apws/261108-retro-comp-andrew-codex-kicad/output/schematic/BOM.csv

Reference | Value | Footprint | Function | Quantity
C1 | 1uF / 16V | Capacitor_THT:CP_Radial_D5.0mm_P2.50mm | Reset timing (+ to RESET_RC) | 1
C2 | 100nF | Capacitor_THT:C_Disc_D5.0mm_W2.5mm_P5.00mm | Bypass U1 | 1
C3 | 100nF | Capacitor_THT:C_Disc_D5.0mm_W2.5mm_P5.00mm | Bypass U2 | 1
C4 | 100nF | Capacitor_THT:C_Disc_D5.0mm_W2.5mm_P5.00mm | Bypass U3 | 1
C5 | 100nF | Capacitor_THT:C_Disc_D5.0mm_W2.5mm_P5.00mm | Bypass U4 | 1
C6 | 100nF | Capacitor_THT:C_Disc_D5.0mm_W2.5mm_P5.00mm | Bypass U5 | 1
C7 | 100nF | Capacitor_THT:C_Disc_D5.0mm_W2.5mm_P5.00mm | Bypass U6 | 1
C8 | 100nF | Capacitor_THT:C_Disc_D5.0mm_W2.5mm_P5.00mm | Bypass U7 | 1
C9 | 100nF | Capacitor_THT:C_Disc_D5.0mm_W2.5mm_P5.00mm | Bypass U8 | 1
C10 | 100nF | Capacitor_THT:C_Disc_D5.0mm_W2.5mm_P5.00mm | Bypass Y1 | 1
C11 | 100nF | Capacitor_THT:C_Disc_D5.0mm_W2.5mm_P5.00mm | Bypass Y2 | 1
C20 | 1uF / 25V | Capacitor_THT:CP_Radial_D5.0mm_P2.50mm | MAX232 C1 flying capacitor | 1
C21 | 1uF / 25V | Capacitor_THT:CP_Radial_D5.0mm_P2.50mm | MAX232 C2 flying capacitor | 1
C22 | 1uF / 25V | Capacitor_THT:CP_Radial_D5.0mm_P2.50mm | MAX232 supply bypass | 1
C23 | 1uF / 25V | Capacitor_THT:CP_Radial_D5.0mm_P2.50mm | MAX232 positive reservoir | 1
C24 | 1uF / 25V | Capacitor_THT:CP_Radial_D5.0mm_P2.50mm | MAX232 negative reservoir (+ to GND) | 1
J1 | RS-232 (DTE pins) | Connector_Dsub:DSUB-9_Socket_Horizontal_P2.77x2.84mm_EdgePinOffset4.94mm_Housed_MountingHolesOffset4.94mm | Female DE9; DTE signal assignment | 1
J2 | PA | Connector_PinHeader_2.54mm:PinHeader_1x08_P2.54mm_Vertical | PIO PA0-7; no power pins | 1
J3 | PB | Connector_PinHeader_2.54mm:PinHeader_1x08_P2.54mm_Vertical | PIO PB0-7; no power pins | 1
J4 | PC | Connector_PinHeader_2.54mm:PinHeader_1x08_P2.54mm_Vertical | PIO PC0-7; no power pins | 1
J5 | +5V INPUT | TerminalBlock_Phoenix:TerminalBlock_Phoenix_MKDS-1,5-2-5.08_1x02_P5.08mm_Horizontal | External regulated +5V; pin 1 positive | 1
R1 | 10k | Resistor_THT:R_Axial_DIN0207_L6.3mm_D2.5mm_P10.16mm_Horizontal | Reset pull-up | 1
R2 | 10 | Resistor_THT:R_Axial_DIN0207_L6.3mm_D2.5mm_P10.16mm_Horizontal | Reset switch discharge limiter | 1
SW1 | RESET | Button_Switch_THT:SW_PUSH_6mm | Reset pushbutton | 1
U1 | Z84C00 | Package_DIP:DIP-40_W15.24mm | CPU | 1
U2 | 62256 | Package_DIP:DIP-28_W15.24mm | RAM 8000-FFFF | 1
U3 | 27C256 | Package_DIP:DIP-28_W15.24mm | ROM 0000-7FFF | 1
U4 | 82C55A | Package_DIP:DIP-40_W15.24mm | PIO 00-03 (mirrored) | 1
U5 | TL16C550CN | Package_DIP:DIP-40_W15.24mm | UART 80-87 (mirrored) | 1
U6 | MAX232 | Package_DIP:DIP-16_W7.62mm | RS-232 transceiver | 1
U7 | 74HCT14 | Package_DIP:DIP-14_W7.62mm | Reset and address inversion | 1
U8 | 74HCT32 | Package_DIP:DIP-14_W7.62mm | Memory and I/O select | 1
Y1 | 4.0000MHz | Oscillator:Oscillator_DIP-14 | CPU oscillator | 1
Y2 | 1.8432MHz | Oscillator:Oscillator_DIP-8 | UART oscillator | 1
