apws/261108-retro-comp-andrew-codex-kicad/reports/firstz80-plan/placement.csv

reference | value | footprint | x_mm | y_mm | x_from_edge_mm | y_from_edge_mm | rotation_deg | pads | pin1_x_mm | pin1_y_mm
C1 | 10uF | Capacitor_THT:CP_Radial_D5.0mm_P2.50mm | 189.9299 | 102.87 | 129.9299 | 42.87 | 0.0 | 2 | 189.9299 | 102.87
C10 | 0.1u | Capacitor_THT:C_Disc_D5.0mm_W2.5mm_P5.00mm | 124.42 | 133.35 | 64.42 | 73.35 | 180.0 | 2 | 124.42 | 133.35
C11 | 0.1u | Capacitor_THT:C_Disc_D5.0mm_W2.5mm_P5.00mm | 111.68 | 133.35 | 51.68 | 73.35 | 180.0 | 2 | 111.68 | 133.35
C12 | 0.1u | Capacitor_THT:C_Disc_D5.0mm_W2.5mm_P5.00mm | 64.135 | 113.07 | 4.135 | 53.07 | -90.0 | 2 | 64.135 | 113.07
C13 | 0.1u | Capacitor_THT:C_Disc_D5.0mm_W2.5mm_P5.00mm | 104.1 | 82.55 | 44.1 | 22.55 | 180.0 | 2 | 104.1 | 82.55
C14 | 0.1uF | Capacitor_THT:C_Disc_D5.0mm_W2.5mm_P5.00mm | 76.2 | 75.34 | 16.2 | 15.34 | 0.0 | 2 | 76.2 | 75.34
C15 | 10uF | Capacitor_THT:CP_Radial_D5.0mm_P2.50mm | 99.6764 | 65.2025 | 39.6764 | 5.2025 | 0.0 | 2 | 99.6764 | 65.2025
C16 | 10uF | Capacitor_THT:CP_Radial_D5.0mm_P2.50mm | 99.642 | 74.2625 | 39.642 | 14.2625 | 0.0 | 2 | 99.642 | 74.2625
C17 | 10uF | Capacitor_THT:CP_Radial_D5.0mm_P2.50mm | 101.6 | 126.68 | 41.6 | 66.68 | 0.0 | 2 | 101.6 | 126.68
C18 | 0.1u | Capacitor_THT:C_Disc_D5.0mm_W2.5mm_P5.00mm | 181.57 | 111.125 | 121.57 | 51.125 | 180.0 | 2 | 181.57 | 111.125
C19 | 0.1u | Capacitor_THT:C_Disc_D5.0mm_W2.5mm_P5.00mm | 97.75 | 133.985 | 37.75 | 73.985 | 180.0 | 2 | 97.75 | 133.985
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
R6 | 470 | Resistor_THT:R_Axial_DIN0207_L6.3mm_D2.5mm_P7.62mm_Horizontal | 137.16 | 76.87 | 77.16 | 16.87 | 90.0 | 2 | 137.16 | 76.87
R7 | 470 | Resistor_THT:R_Axial_DIN0207_L6.3mm_D2.5mm_P7.62mm_Horizontal | 142.24 | 76.87 | 82.24 | 16.87 | 90.0 | 2 | 142.24 | 76.87
R8 | 470 | Resistor_THT:R_Axial_DIN0207_L6.3mm_D2.5mm_P7.62mm_Horizontal | 147.32 | 76.87 | 87.32 | 16.87 | 90.0 | 2 | 147.32 | 76.87
R9 | 470 | Resistor_THT:R_Axial_DIN0207_L6.3mm_D2.5mm_P7.62mm_Horizontal | 128.27 | 140.97 | 68.27 | 80.97 | 0.0 | 2 | 128.27 | 140.97
SW1 | RESET | Button_Switch_THT:SW_PUSH_6mm | 188.52 | 122.845 | 128.52 | 62.845 | 0.0 | 4 | 188.52 | 122.845
TP1 | VCC | Connector_PinHeader_2.54mm:PinHeader_1x01_P2.54mm_Vertical | 137.16 | 154.94 | 77.16 | 94.94 | 0.0 | 1 | 137.16 | 154.94
TP2 | GND | Connector_PinHeader_2.54mm:PinHeader_1x01_P2.54mm_Vertical | 76.2 | 154.94 | 16.2 | 94.94 | 0.0 | 1 | 76.2 | 154.94
U1 | 74LS14 | Package_DIP:DIP-14_W7.62mm_Socket_LongPads | 117.07 | 138.1 | 57.07 | 78.1 | 0.0 | 14 | 117.07 | 138.1
U2 | Z80CPU | Package_DIP:DIP-40_W15.24mm_Socket_LongPads | 68.805 | 87.635 | 8.805 | 27.635 | 0.0 | 40 | 68.805 | 87.635
U3 | 74LS32 | Package_DIP:DIP-14_W7.62mm_Socket_LongPads | 104.37 | 138.1 | 44.37 | 78.1 | 0.0 | 14 | 104.37 | 138.1
U4 | KM62256CLP | Package_DIP:DIP-28_W15.24mm_Socket_LongPads | 109.445 | 87.64 | 49.445 | 27.64 | 0.0 | 28 | 109.445 | 87.64
U5 | 8255 | Package_DIP:DIP-40_W15.24mm_Socket_LongPads | 129.765 | 87.635 | 69.765 | 27.635 | 0.0 | 40 | 129.765 | 87.635
U6 | 28C256 | Package_DIP:DIP-28_W15.24mm_Socket_LongPads | 89.125 | 87.615 | 29.125 | 27.615 | 0.0 | 28 | 89.125 | 87.615
U7 | 16550 | Package_DIP:DIP-40_W15.24mm_Socket_LongPads | 150.085 | 87.635 | 90.085 | 27.635 | 0.0 | 40 | 150.085 | 87.635
U8 | MAX232 | Package_DIP:DIP-16_W7.62mm_Socket_LongPads | 178.52 | 85.06 | 118.52 | 25.06 | 0.0 | 16 | 178.52 | 85.06
U9 | LM7805_TO220 | Package_TO_SOT_THT:TO-220-3_Horizontal_TabDown | 108.245 | 66.04 | 48.245 | 6.04 | -90.0 | 4 | 108.245 | 66.04
X1 | CLK-CPU | Oscillator:Oscillator_DIP-14 | 90.4 | 139.7 | 30.4 | 79.7 | -90.0 | 4 | 90.4 | 139.7
X2 | CLK-UART | Oscillator:Oscillator_DIP-14 | 173.99 | 116.84 | 113.99 | 56.84 | -90.0 | 4 | 173.99 | 116.84
