apws/261108-retro-comp-andrew-codex-kicad/reference/grok-agy/docs/images/261106-18 google antigravity agy install linux -- Screenshot_20261106_185919.png

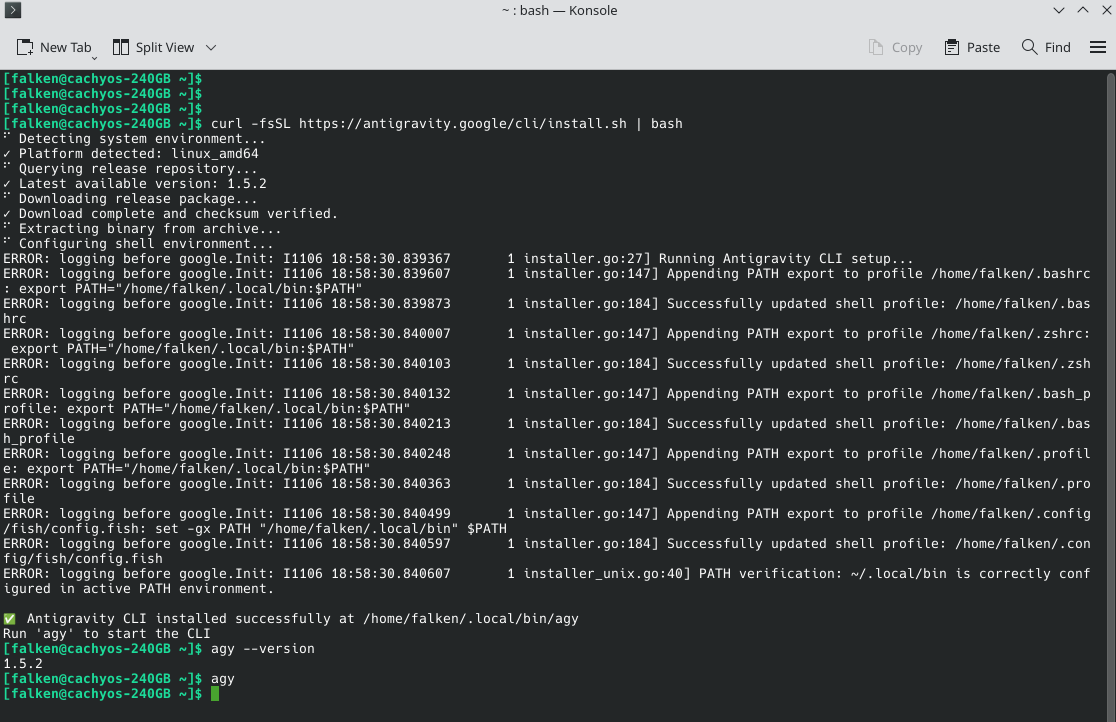
reference/grok-agy/docs/images/261106-18 google antigravity agy install linux -- Screenshot_20261106_185919.png
