apws/261108-retro-comp-andrew-codex-kicad/reference/grok-agy/docs/images/261106-21 google agy - Andrews board routing result (4 layer) - Screenshot_20261106_214348.png

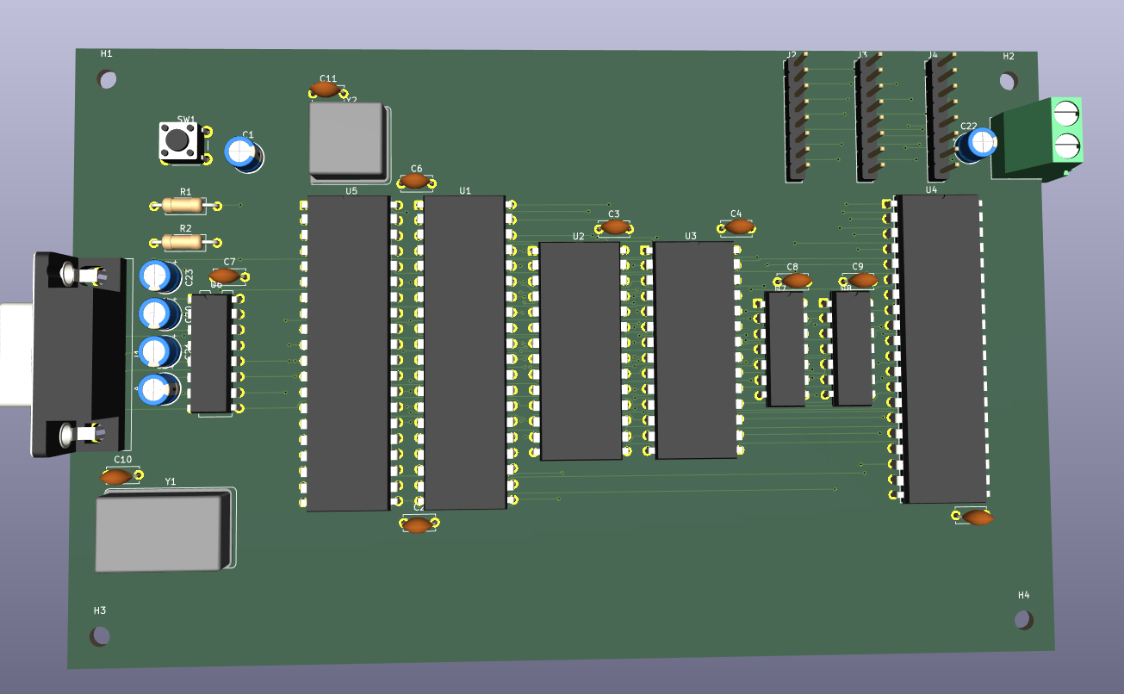
reference/grok-agy/docs/images/261106-21 google agy - Andrews board routing result (4 layer) - Screenshot_20261106_214348.png
