apws/261108-retro-comp-andrew-codex-kicad/reference/source/z80test.png

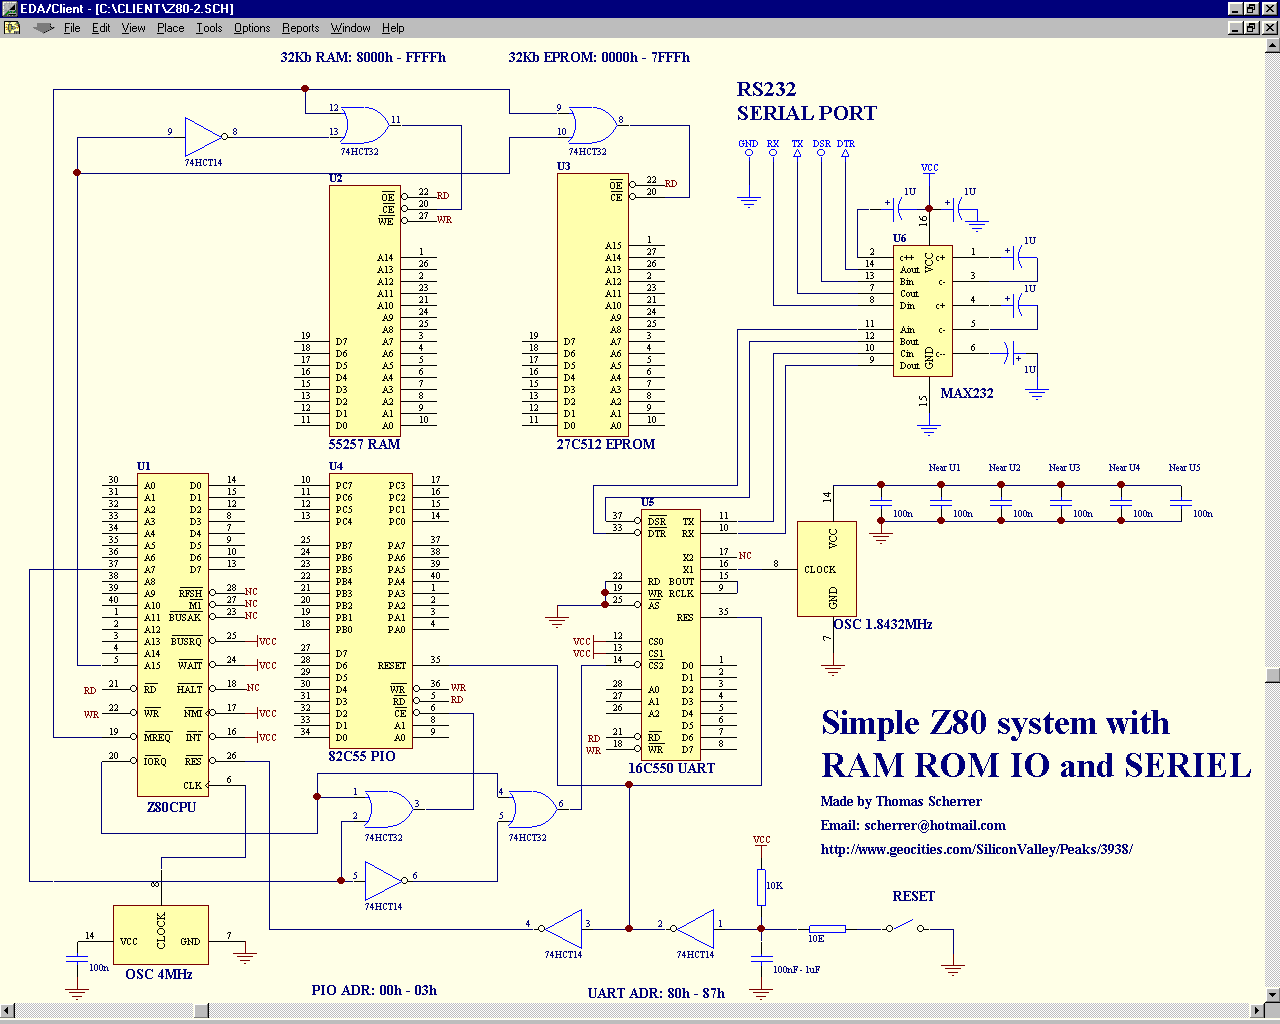
reference/source/z80test.png
