apws/261108-retro-comp-andrew-codex-kicad/output/pdf/schematic-7805.pdf

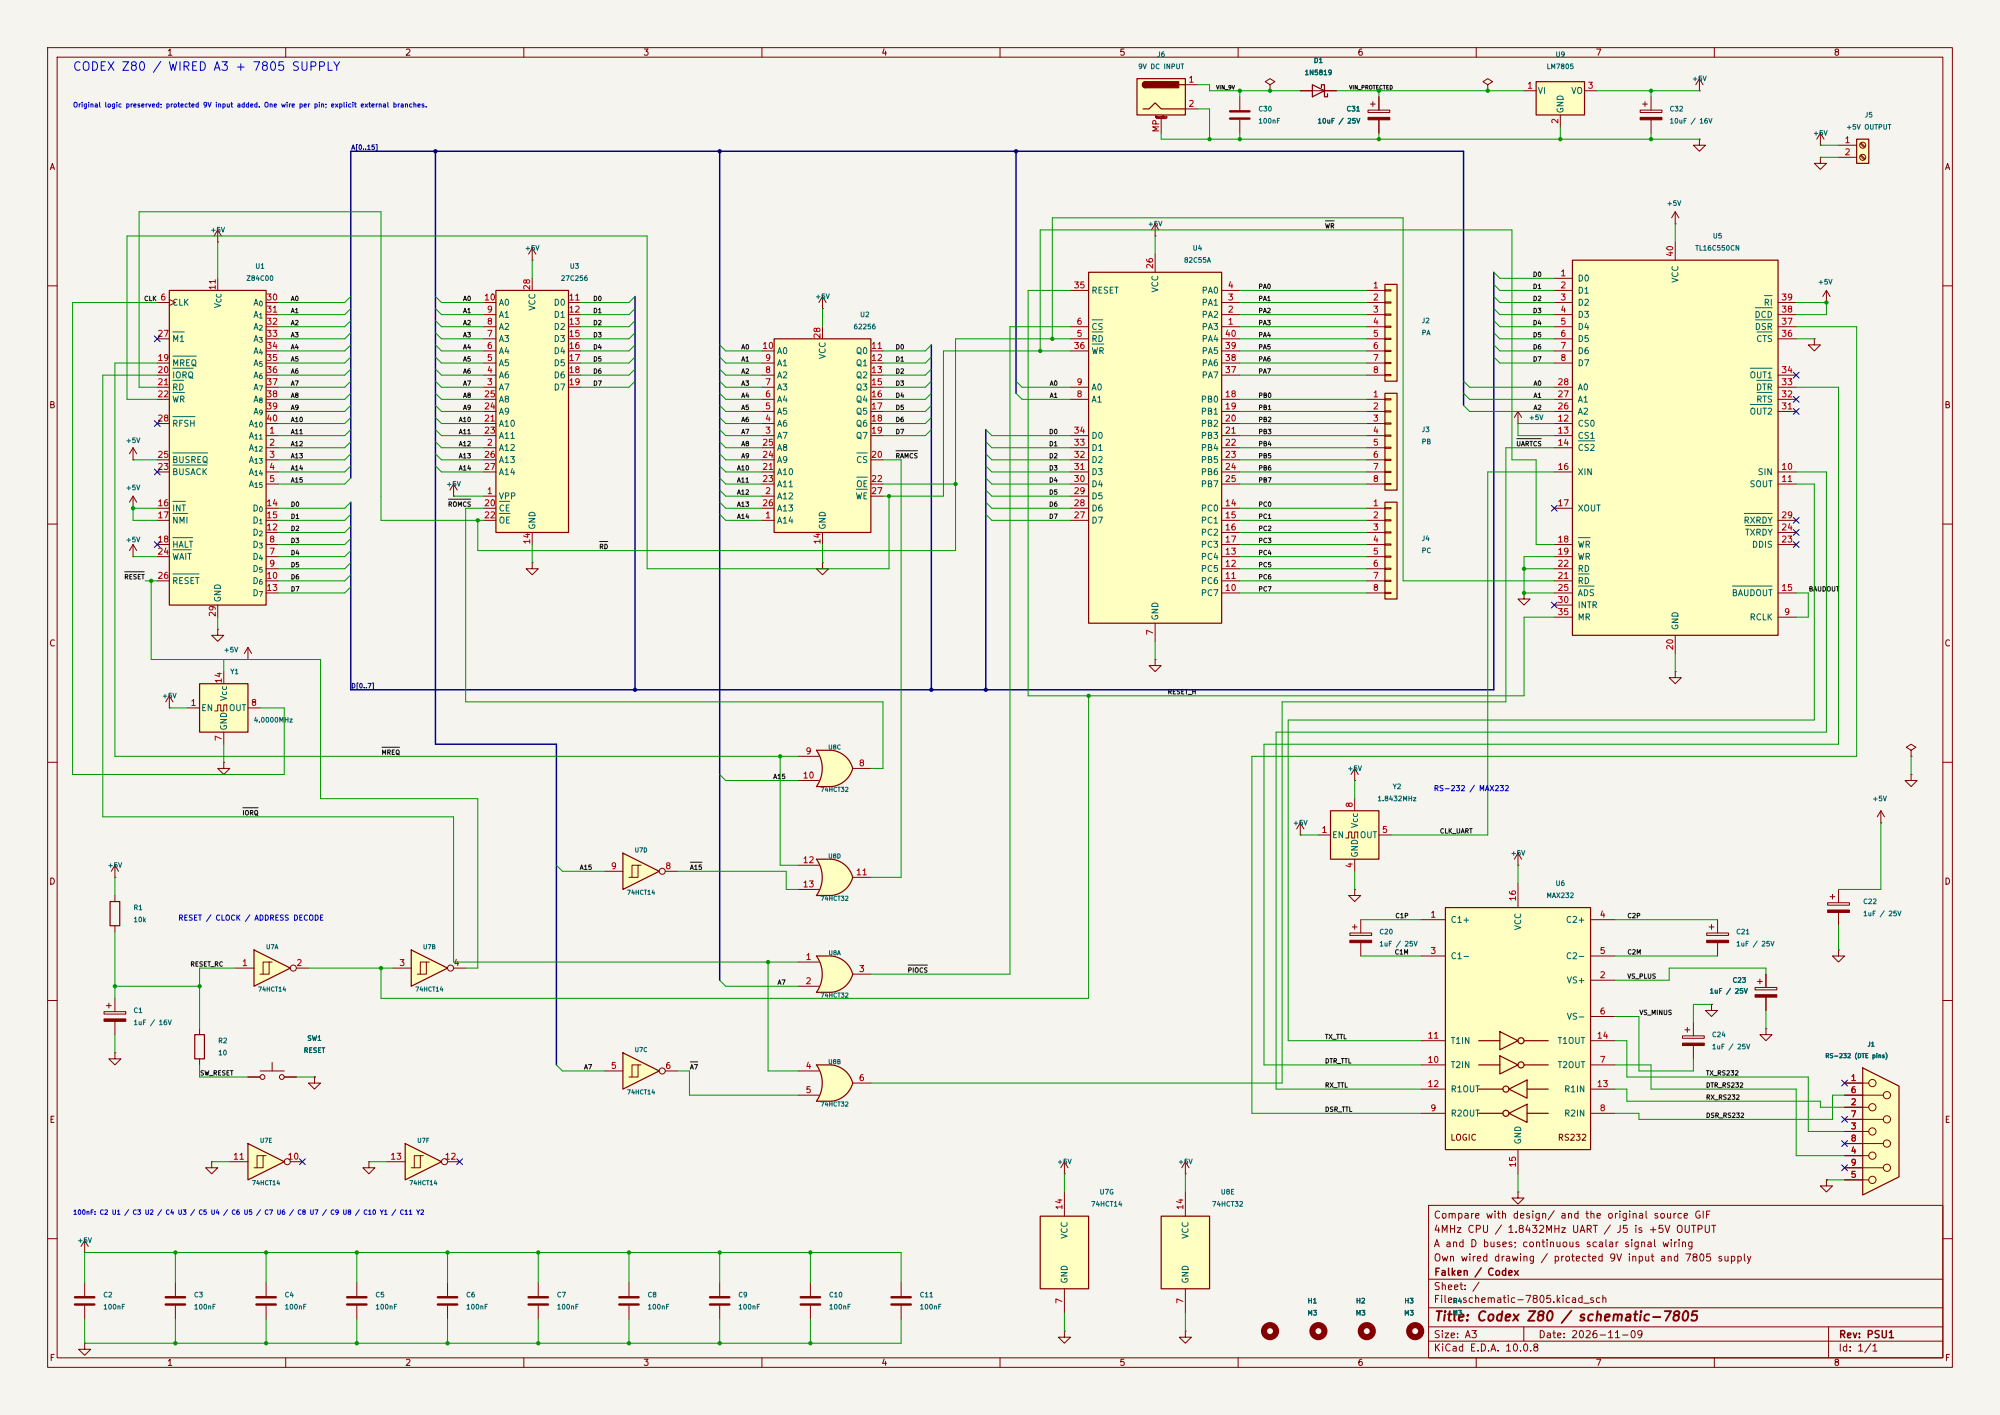
[picture p55: page 1]

Original logic preserved; protected 9V input added. One wire per pin; explicit external branches.

VCC 11 D2 12 D7 13 D0 14 D1 15 INT 16 NMI 17 HALT 18 MREQ 19

100nF: C2 U1 / C3 U2 / C4 U3 / C5 U4 / C6 U5 / C7 U6 / C8 U7 / C9 U8 / C10 Y1 / C11 Y2 RESET / CLOCK / ADDRESS DECODE

Compare with design/ and the original source GIF
4MHz CPU / 1.8432MHz UART / J5 is +5V OUTPUT
A and D buses; continuous scalar signal wiring
Own wired drawing / protected 9V input and 7805 supply
Falken / Codex
Sheet: /
File: schematic-7805.kicad_sch
Title: Codex Z80 / schematic-7805

Size: A3 | Rev: PSU1 | F Date: 2026-11-09
KiCad E.D.A. 10.0.8 | Id: 1/1
