apws/261108-retro-comp-andrew-codex-kicad/output/pdf/Z80_Simple_Computer-wired-A3.pdf

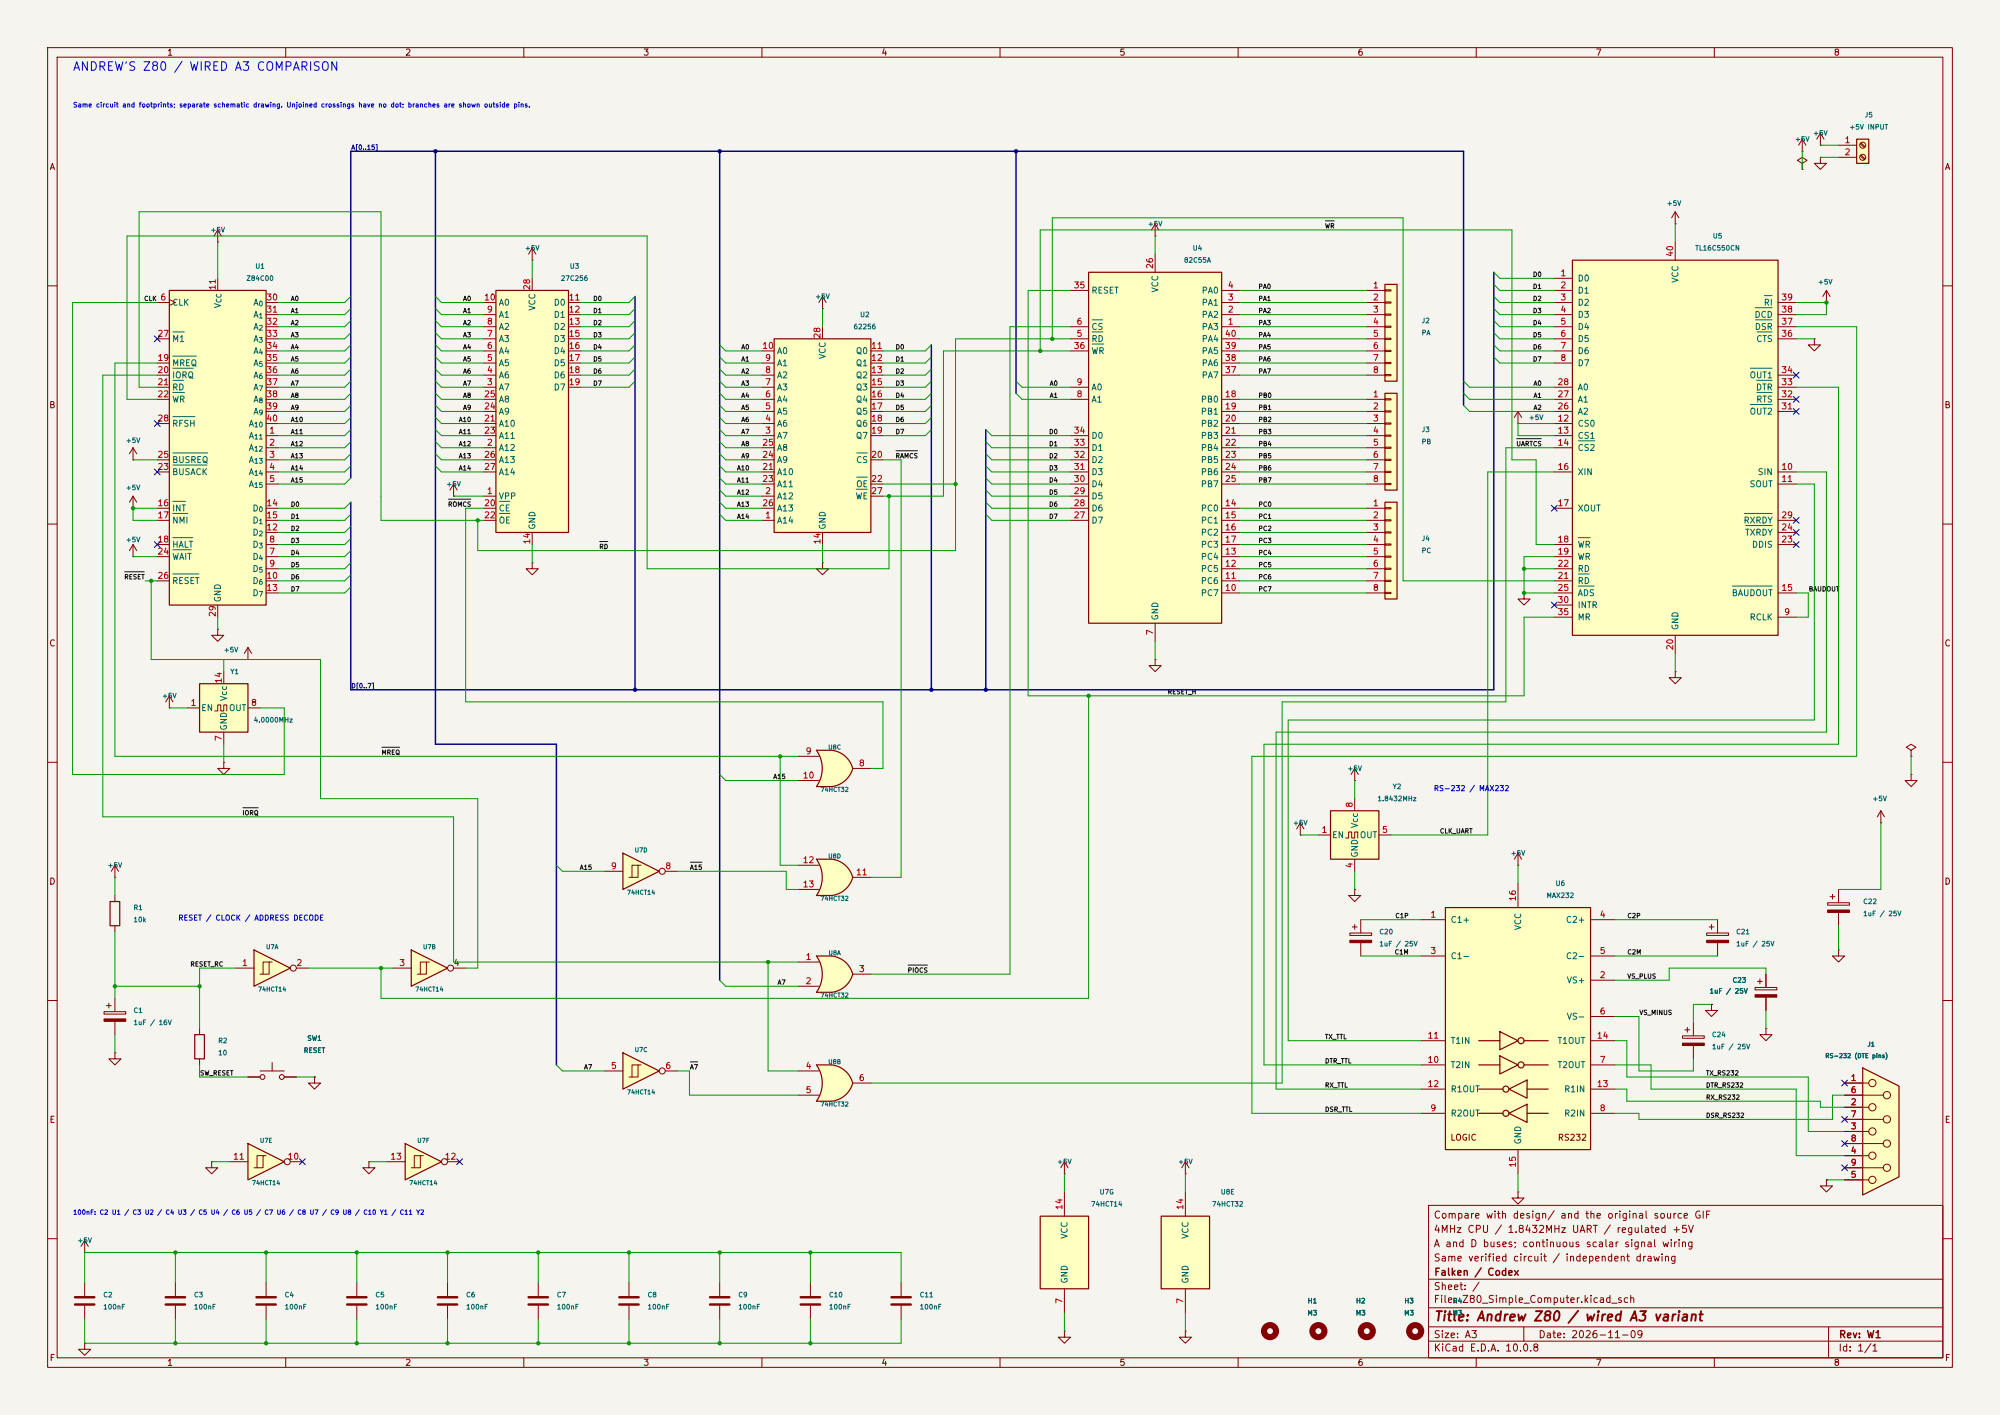
[picture p56: page 1]

Same circuit and footprints; separate schematic drawing. Unjoined crossings have no dot; branches are shown outside pins.
A0D4D3D2D7D6D5 PB0 PC0 PC5 CLK

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

RS-232 / MAX232 RESET / CLOCK / ADDRESS DECODE

Compare with design/ and the original source GIF
4MHz CPU / 1.8432MHz UART / regulated +5V
A and D buses; continuous scalar signal wiring
Same verified circuit / independent drawing
Falken / Codex
Sheet: /
File: Z80_Simple_Computer.kicad_sch
Title: Andrew Z80 / wired A3 variant

Size: A3 | Rev: W1 | F Date: 2026-11-09
KiCad E.D.A. 10.0.8 | Id: 1/1
