apws/261108-retro-comp-andrew-codex-kicad/(list of files, drawings)

Other design files:
reports/firstz80/03-freerouting/FirstZ80.dsn
reports/firstz80/03-freerouting/FirstZ80.raw.dsn
reports/routing/04-freerouting/setup-attempts/01-autoroute-settings-before-layers.dsn
reports/routing/04-freerouting/setup-attempts/02-settings-after-planes-empty-board.dsn
reports/routing/04-freerouting/Z80_Simple_Computer.dsn
reports/routing/04-freerouting/Z80_Simple_Computer.raw.dsn
