apws/261108-retro-comp-andrew-codex-kicad/reports/firstz80/01-manhattan/attempt-01/FirstZ80.kicad_pcb

## KiCad design reports/firstz80/01-manhattan/attempt-01/FirstZ80.kicad_pcb (2026-11-09)

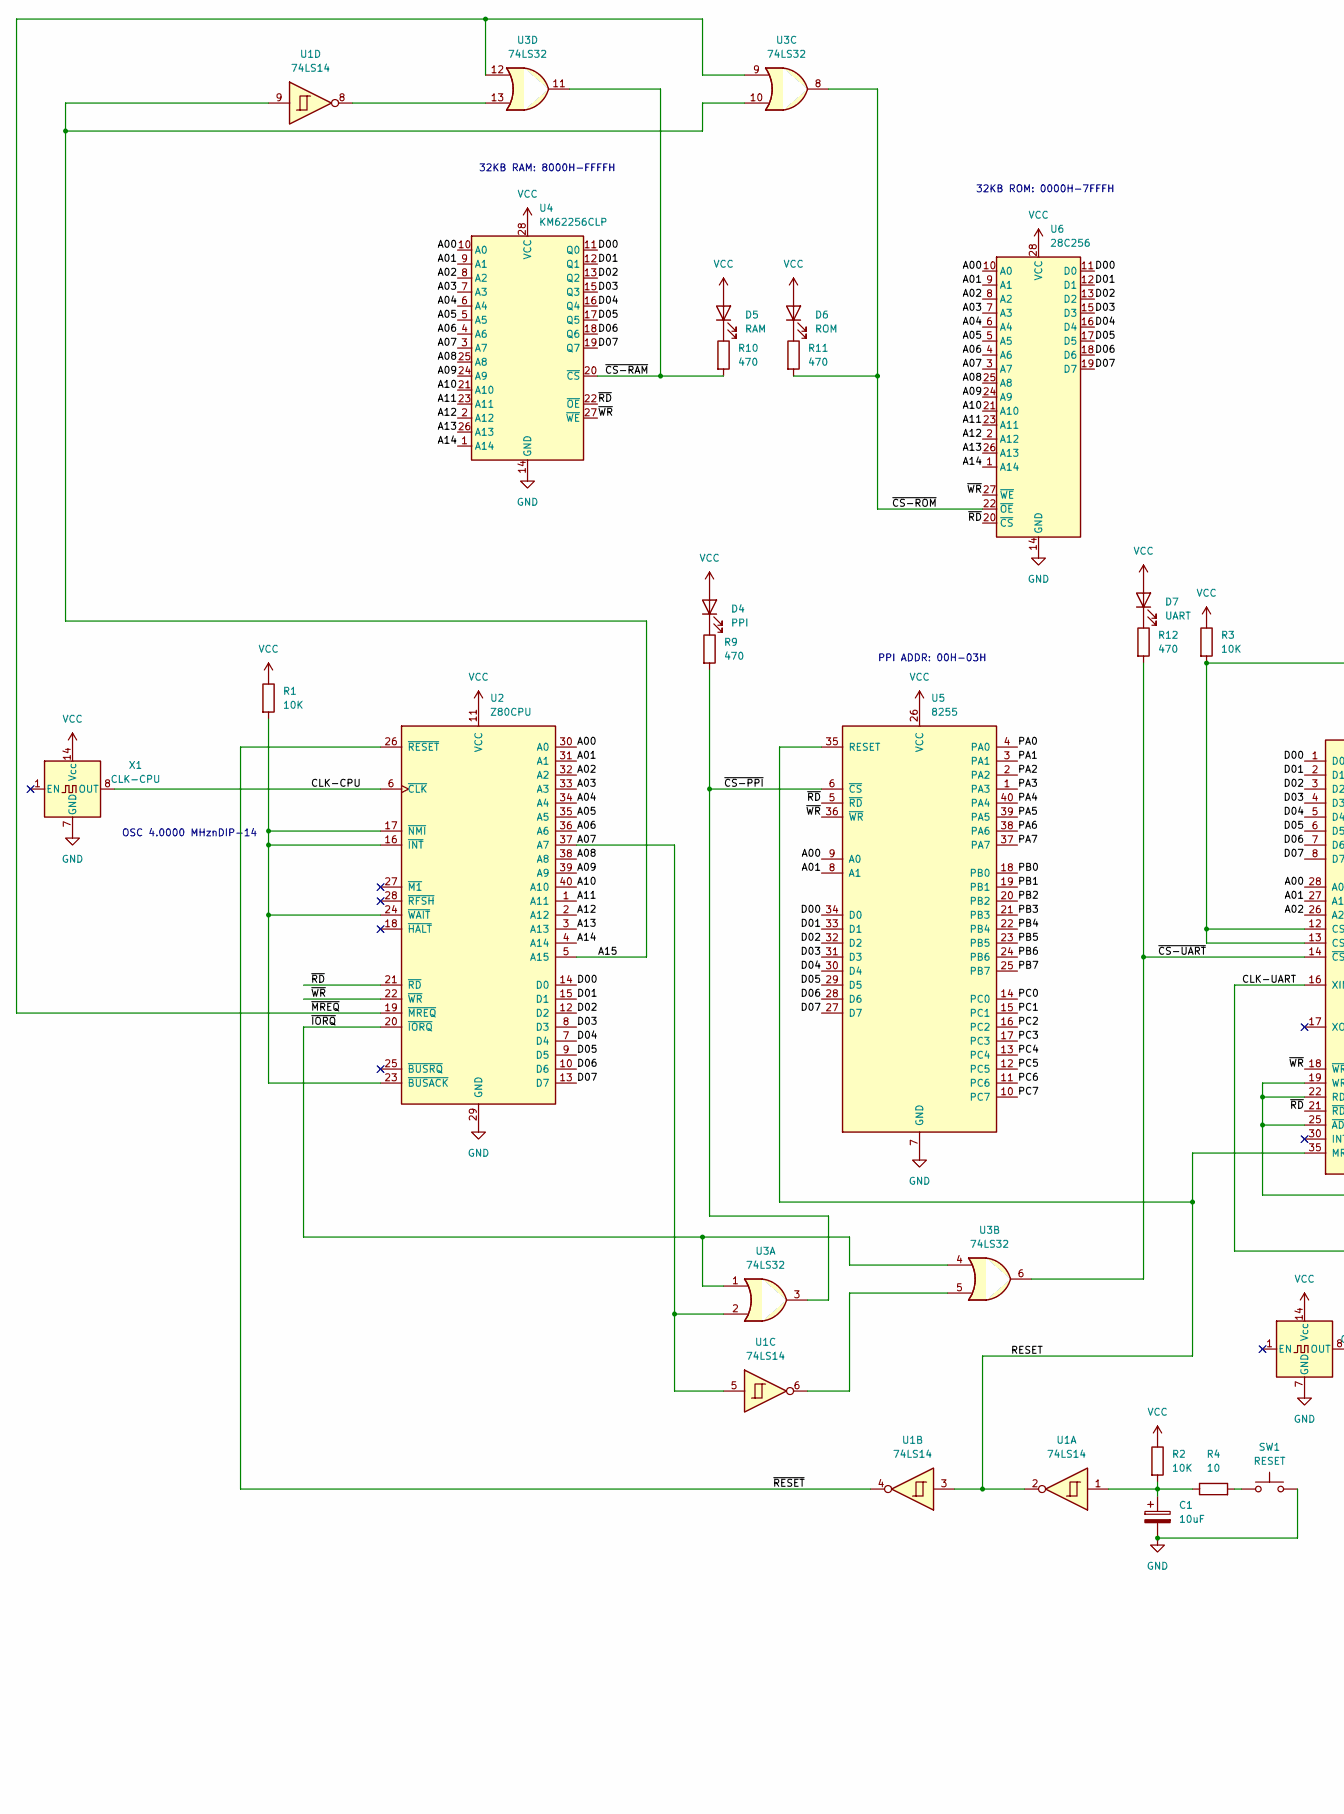
[picture p57: schematic FirstZ80.kicad_sch, part in row 1, column 1]

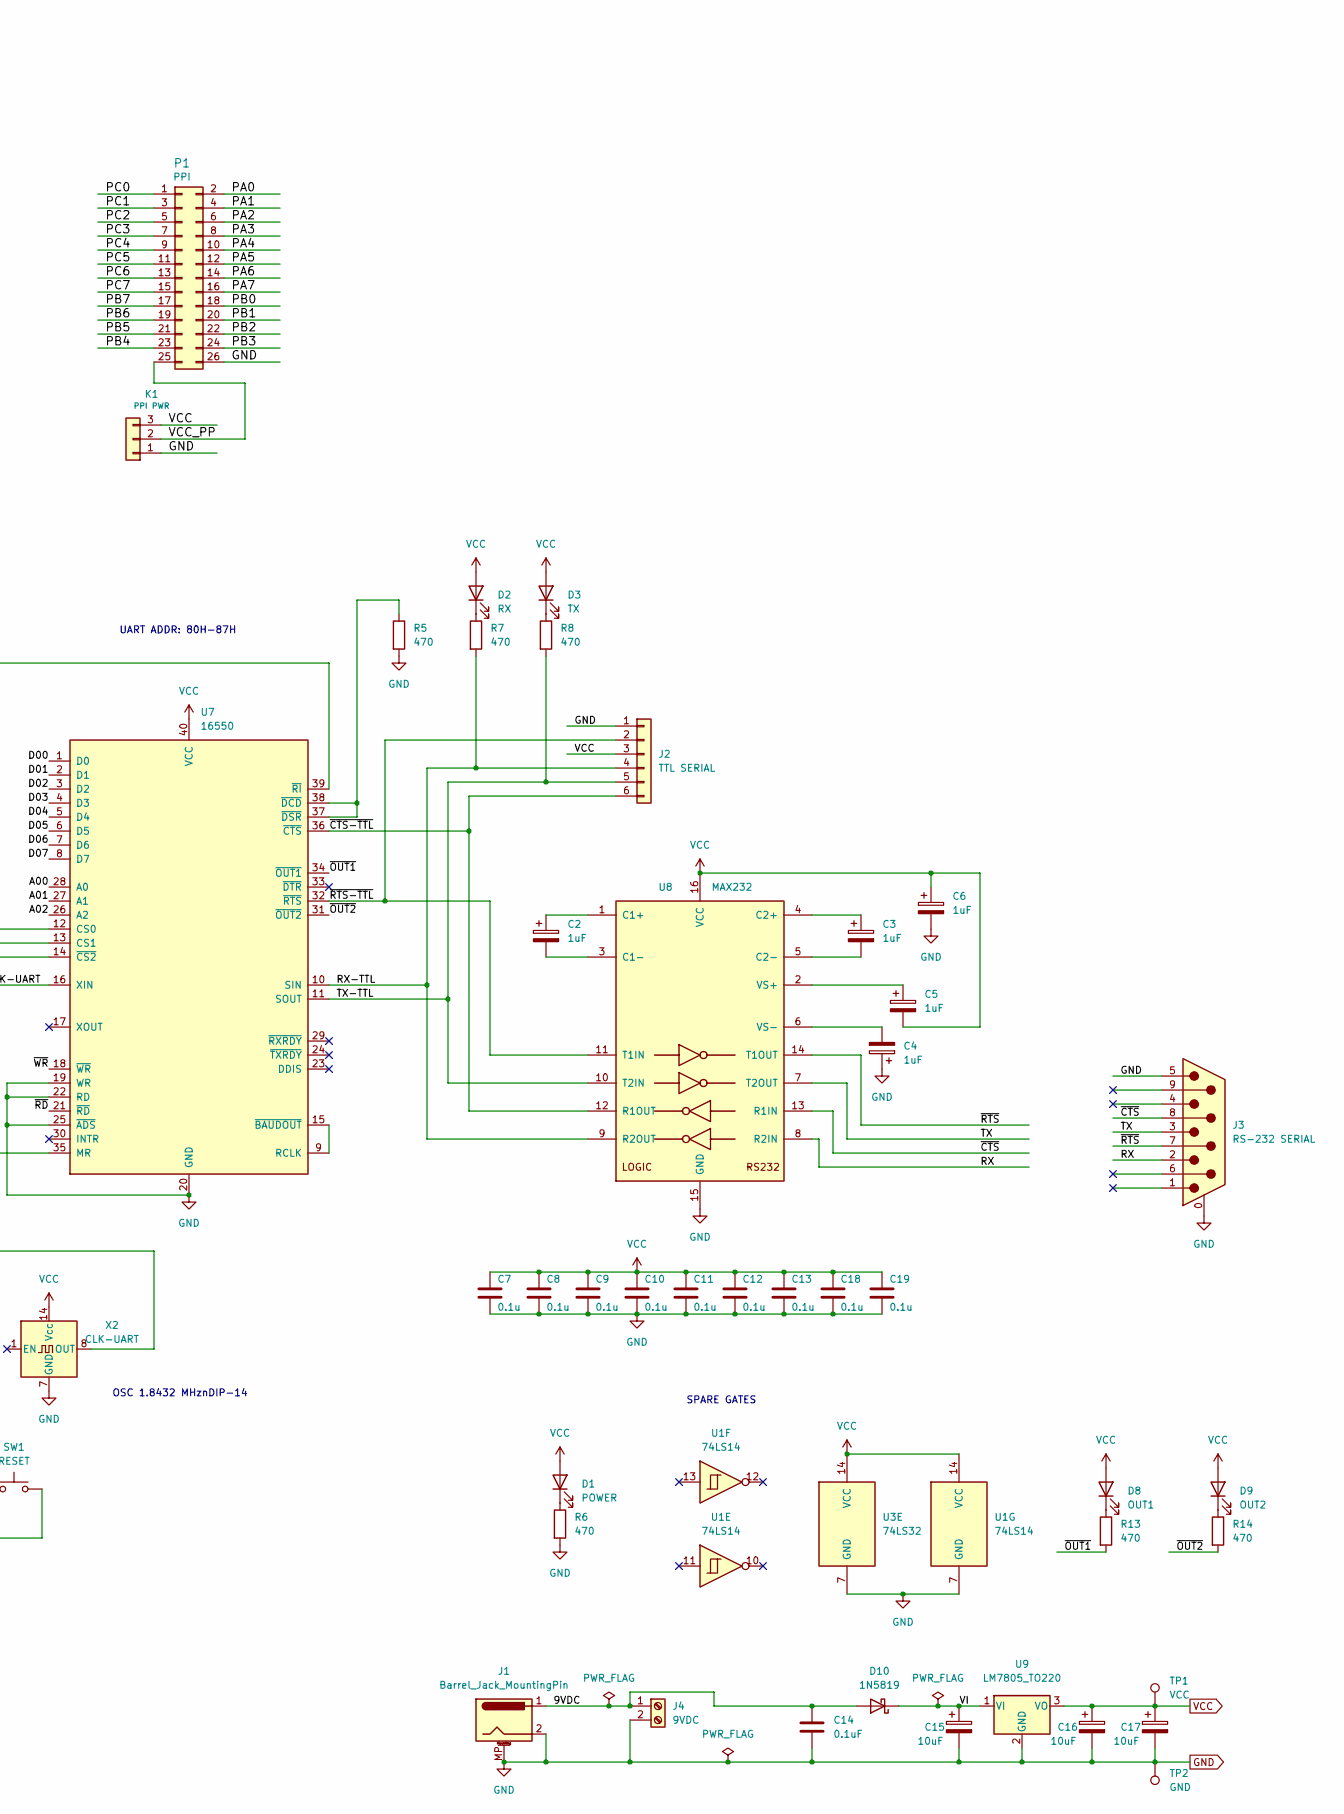
[picture p58: schematic FirstZ80.kicad_sch, part in row 1, column 2]

Parts:
C1, C15, C16, C17: 10uF; Capacitor_THT__CP_Radial_D5.0mm_P2.50mm
C2, C3, C4, C5, C6: 1uF; Capacitor_THT__CP_Radial_D5.0mm_P2.50mm
C7, C8, C9, C10, C11, C12, C13, C18, C19: 0.1u; Capacitor_THT__C_Disc_D5.0mm_W2.5mm_P5.00mm
C14: 0.1uF; Capacitor_THT__C_Disc_D5.0mm_W2.5mm_P5.00mm
D1: POWER; LED_THT__LED_D3.0mm
D2: RX; LED_THT__LED_D3.0mm
D3: TX; LED_THT__LED_D3.0mm
D4: PPI; LED_THT__LED_D3.0mm
D5: RAM; LED_THT__LED_D3.0mm
D6: ROM; LED_THT__LED_D3.0mm
D7: UART; LED_THT__LED_D3.0mm
D8: OUT1; LED_THT__LED_D3.0mm
D9: OUT2; LED_THT__LED_D3.0mm
D10: 1N5819; Diode_THT__D_DO-41_SOD81_P10.16mm_Horizontal
J1: Barrel_Jack_MountingPin; Connector_BarrelJack__BarrelJack_Horizontal
J2: TTL SERIAL; Connector_PinHeader_2.54mm__PinHeader_1x06_P2.54mm_Horizont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
J3: RS-232 SERIAL; Connector_Dsub__DSUB-9_Male_Horizontal_P2.77x2.84mm_EdgePin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
J4: 9VDC; TerminalBlock_Phoenix__TerminalBlock_Phoenix_MKDS-1,5-2-5.0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
K1: PPI PWR; Connector_PinHeader_2.54mm__PinHeader_1x03_P2.54mm_Vertical
P1: PPI; Connector_IDC__IDC-Header_2x13_P2.54mm_Horizontal
R1, R2, R3: 10K; Resistor_THT__R_Axial_DIN0207_L6.3mm_D2.5mm_P7.62mm_Horizon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
R4: 10; Resistor_THT__R_Axial_DIN0207_L6.3mm_D2.5mm_P7.62mm_Horizon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
R5, R6, R7, R8, R9, R10, R11, R12, R13, R14: 470; Resistor_THT__R_Axial_DIN0207_L6.3mm_D2.5mm_P7.62mm_Horizon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
SW1: RESET; Button_Switch_THT__SW_PUSH_6mm
TP1: VCC; Connector_PinHeader_2.54mm__PinHeader_1x01_P2.54mm_Vertical
TP2: GND; Connector_PinHeader_2.54mm__PinHeader_1x01_P2.54mm_Vertical
U1: 74LS14; Package_DIP__DIP-14_W7.62mm_Socket_LongPads
U2: Z80CPU; Package_DIP__DIP-40_W15.24mm_Socket_LongPads
U3: 74LS32; Package_DIP__DIP-14_W7.62mm_Socket_LongPads
U4: KM62256CLP; Package_DIP__DIP-28_W15.24mm_Socket_LongPads
U5: 8255; Package_DIP__DIP-40_W15.24mm_Socket_LongPads
U6: 28C256; Package_DIP__DIP-28_W15.24mm_Socket_LongPads
U7: 16550; Package_DIP__DIP-40_W15.24mm_Socket_LongPads
U8: MAX232; Package_DIP__DIP-16_W7.62mm_Socket_LongPads
U9: LM7805_TO220; Package_TO_SOT_THT__TO-220-3_Horizontal_TabDown
X1: CLK-CPU; Oscillator__Oscillator_DIP-14
X2: CLK-UART; Oscillator__Oscillator_DIP-14

Connections:
/9VDC: C14.1, D10.2 (A), J1.1, J4.1
/A00: U2.30 (A0), U4.10 (A0), U5.9 (A0), U6.10 (A0), U7.28 (A0)
/A01: U2.31 (A1), U4.9 (A1), U5.8 (A1), U6.9 (A1), U7.27 (A1)
/A02: U2.32 (A2), U4.8 (A2), U6.8 (A2), U7.26 (A2)
/A03: U2.33 (A3), U4.7 (A3), U6.7 (A3)
/A04: U2.34 (A4), U4.6 (A4), U6.6 (A4)
/A05: U2.35 (A5), U4.5 (A5), U6.5 (A5)
/A06: U2.36 (A6), U4.4 (A6), U6.4 (A6)
/A07: U1.5, U2.37 (A7), U3.2, U4.3 (A7), U6.3 (A7)
/A08: U2.38 (A8), U4.25 (A8), U6.25 (A8)
/A09: U2.39 (A9), U4.24 (A9), U6.24 (A9)
/A10: U2.40 (A10), U4.21 (A10), U6.21 (A10)
/A11: U2.1 (A11), U4.23 (A11), U6.23 (A11)
/A12: U2.2 (A12), U4.2 (A12), U6.2 (A12)
/A13: U2.3 (A13), U4.26 (A13), U6.26 (A13)
/A14: U2.4 (A14), U4.1 (A14), U6.1 (A14)
/A15: U1.9, U2.5 (A15), U3.10
/CLK-CPU: U2.6 (~CLK), X1.8 (OUT)
/CLK-UART: U7.16 (XIN), X2.8 (OUT)
/D00: U2.14 (D0), U4.11 (Q0), U5.34 (D0), U6.11 (D0), U7.1 (D0)
/D01: U2.15 (D1), U4.12 (Q1), U5.33 (D1), U6.12 (D1), U7.2 (D1)
/D02: U2.12 (D2), U4.13 (Q2), U5.32 (D2), U6.13 (D2), U7.3 (D2)
/D03: U2.8 (D3), U4.15 (Q3), U5.31 (D3), U6.15 (D3), U7.4 (D3)
/D04: U2.7 (D4), U4.16 (Q4), U5.30 (D4), U6.16 (D4), U7.5 (D4)
/D05: U2.9 (D5), U4.17 (Q5), U5.29 (D5), U6.17 (D5), U7.6 (D5)
/D06: U2.10 (D6), U4.18 (Q6), U5.28 (D6), U6.18 (D6), U7.7 (D6)
/D07: U2.13 (D7), U4.19 (Q7), U5.27 (D7), U6.19 (D7), U7.8 (D7)
/PA0: P1.2, U5.4 (PA0)
/PA1: P1.4, U5.3 (PA1)
/PA2: P1.6, U5.2 (PA2)
/PA3: P1.8, U5.1 (PA3)
/PA4: P1.10, U5.40 (PA4)
/PA5: P1.12, U5.39 (PA5)
/PA6: P1.14, U5.38 (PA6)
/PA7: P1.16, U5.37 (PA7)
/PB0: P1.18, U5.18 (PB0)
/PB1: P1.20, U5.19 (PB1)
/PB2: P1.22, U5.20 (PB2)
/PB3: P1.24, U5.21 (PB3)
/PB4: P1.23, U5.22 (PB4)
/PB5: P1.21, U5.23 (PB5)
/PB6: P1.19, U5.24 (PB6)
/PB7: P1.17, U5.25 (PB7)
/PC0: P1.1, U5.14 (PC0)
/PC1: P1.3, U5.15 (PC1)
/PC2: P1.5, U5.16 (PC2)
/PC3: P1.7, U5.17 (PC3)
/PC4: P1.9, U5.13 (PC4)
/PC5: P1.11, U5.12 (PC5)
/PC6: P1.13, U5.11 (PC6)
/PC7: P1.15, U5.10 (PC7)
/RESET: U1.2, U1.3, U5.35 (RESET), U7.35 (MR)
/RX: J3.2, U8.8 (R2IN)
/RX-TTL: J2.4, R7.2, U7.10 (SIN), U8.9 (R2OUT)
/TX: J3.3, U8.7 (T2OUT)
/TX-TTL: J2.5, R8.2, U7.11 (SOUT), U8.10 (T2IN)
/VCC_PP: K1.2, P1.25
/VI: C15.1, D10.1 (K), U9.1 (VI)
/~CS-PPI: R9.2, U3.3, U5.6 (~CS)
/~CS-RAM: R10.2, U3.11, U4.20 (~CS)
/~CS-ROM: R11.2, U3.8, U6.22 (~OE)
/~CS-UART: R12.2, U3.6, U7.14 (~CS2)
/~CTS-TTL: J2.6, U7.36 (~CTS), U8.12 (R1OUT)
/~CTS: J3.8, U8.13 (R1IN)
/~IORQ: U2.20 (~IORQ), U3.1, U3.4
/~MREQ: U2.19 (~MREQ), U3.9, U3.12
/~OUT1: R13.2, U7.34 (~OUT1)
/~OUT2: R14.2, U7.31 (~OUT2)
/~RD: U2.21 (~RD), U4.22 (~OE), U5.5 (~RD), U6.20 (~CS), U7.21 (~RD)
/~RESET: U1.4, U2.26 (~RESET)
/~RTS-TTL: J2.2, U7.32 (~RTS), U8.11 (T1IN)
/~RTS: J3.7, U8.14 (T1OUT)
/~WR: U2.22 (~WR), U4.27 (~WE), U5.36 (~WR), U6.27 (~WE), U7.18 (~WR)
GND: C1.2, C4.1, C6.2, C7.2, C8.2, C9.2, C10.2, C11.2, C12.2, C13.2, C14.2, C15.2, C16.2, C17.2, C18.2, C19.2, J1.2, J1.MP (MountPin), J2.1, J3.0 (PAD), J3.5, J4.2, K1.1, P1.26, R5.2, R6.2, SW1.2, TP2.1, U1.7 (GND), U2.29 (GND), U3.7 (GND), U4.14 (GND), U5.7 (GND), U6.14 (GND), U7.19 (WR), U7.20 (GND), U7.22 (RD), U7.25 (~ADS), U8.15 (GND), U9.2 (GND), X1.7 (GND), X2.7 (GND)
unnamed: C1.1, R2.2, R4.1, U1.1
unnamed: D1.1 (K), R6.1
unnamed: D2.1 (K), R7.1
unnamed: D3.1 (K), R8.1
unnamed: D4.1 (K), R9.1
unnamed: D5.1 (K), R10.1
unnamed: D6.1 (K), R11.1
unnamed: D7.1 (K), R12.1
unnamed: D8.1 (K), R13.1
unnamed: D9.1 (K), R14.1
unnamed: R4.2, SW1.1
unnamed: U1.6, U3.5
unnamed: U1.8, U3.13
unnamed: R1.2, U2.16 (~INT), U2.17 (~NMI), U2.23 (~BUSACK), U2.24 (~WAIT)
unnamed: R3.2, U7.12 (CS0), U7.13 (CS1), U7.39 (~RI)
unnamed: U7.9 (RCLK), U7.15 (~BAUDOUT)
unnamed: R5.1, U7.37 (~DSR), U7.38 (~DCD)
unnamed: C2.1, U8.1 (C1+)
unnamed: C2.2, U8.3 (C1-)
unnamed: C3.1, U8.4 (C2+)
unnamed: C3.2, U8.5 (C2-)
unnamed: C5.1, U8.2 (VS+)
unnamed: C4.2, U8.6 (VS-)
VCC: C5.2, C6.1, C7.1, C8.1, C9.1, C10.1, C11.1, C12.1, C13.1, C16.1, C17.1, C18.1, C19.1, D1.2 (A), D2.2 (A), D3.2 (A), D4.2 (A), D5.2 (A), D6.2 (A), D7.2 (A), D8.2 (A), D9.2 (A), J2.3, K1.3, R1.1, R2.1, R3.1, TP1.1, U1.14 (VCC), U2.11 (VCC), U3.14 (VCC), U4.28 (VCC), U5.26 (VCC), U6.28 (VCC), U7.40 (VCC), U8.16 (VCC), U9.3 (VO), X1.14 (Vcc), X2.14 (Vcc)

Notes on the sheet:
UART ADDR: 80H-87H
SPARE GATES
PPI ADDR: 00H-03H
OSC 1.8432 MHznDIP-14
32KB ROM: 0000H-7FFFH
32KB RAM: 8000H-FFFFH
OSC 4.0000 MHznDIP-14

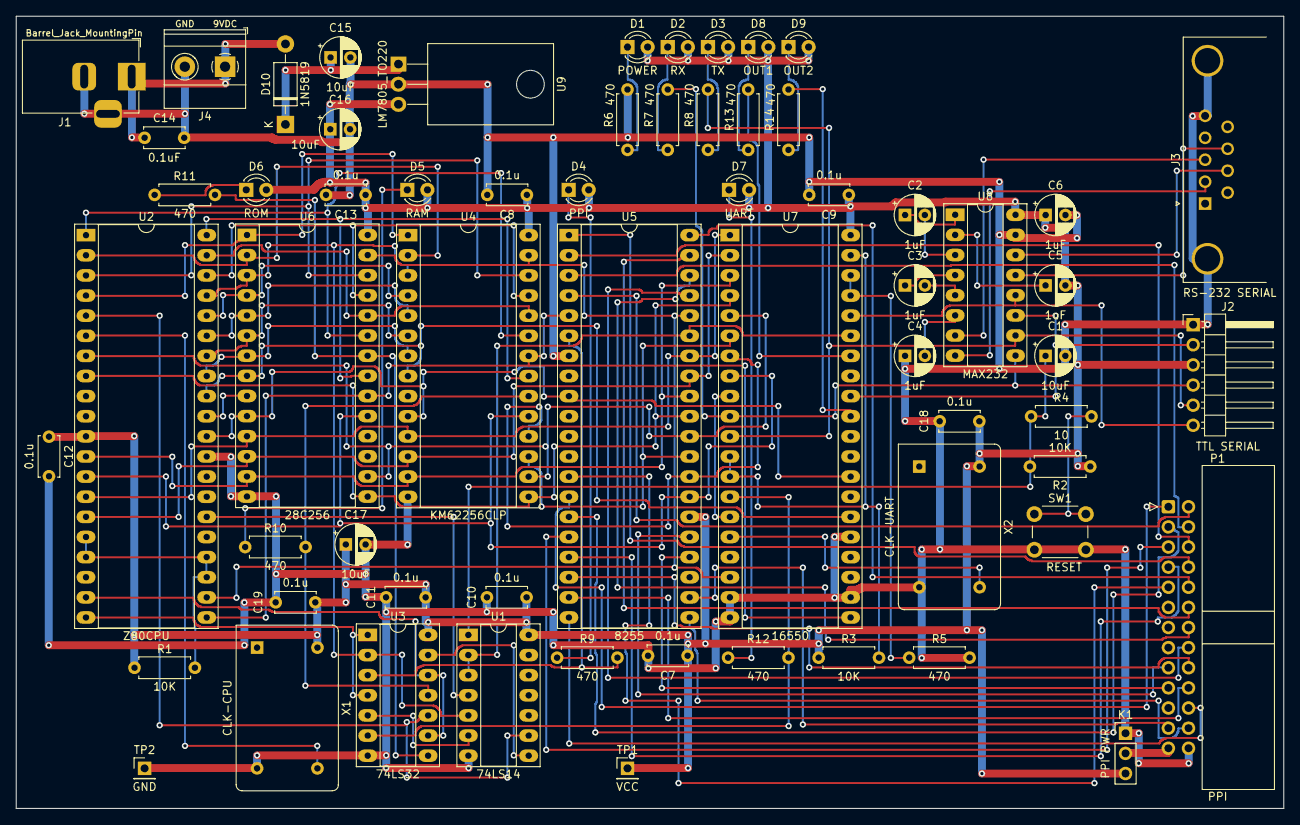
[picture p59: board FirstZ80.kicad_pcb from above]

Board: 2 copper layers, 160.0 x 100.0 mm, 63 parts (0 on the bottom side), 98 nets.
