apws/261108-retro-comp-andrew-codex-kicad/(commit log)

2026-11-08 Preserve Andrew Z80 schematic and three verified routing experiments
    Snapshot the existing Codex project, common placed input, adapted AGY and Codex routers, local FreeRouting MCP result, retained incomplete CLI controls, and native verification evidence. Include review instructions and vendored project libraries; keep native interactive variant 3 pending.
    [01-autoroute-settings-before-layers.dsn, 02-settings-after-planes-empty-board.dsn, BOM.csv, Z80_Simple_Computer.dsn, Z80_Simple_Computer.kicad_pcb, Z80_Simple_Computer.kicad_sch, Z80_Simple_Computer.raw.dsn, route-worksheet.csv]
2026-11-09 Add wired single-A3 schematic variant with exact circuit parity
    Keep the accepted label-oriented design and all PCB experiments intact. Add explicit bus backbones, 95 bus entries, 55 continuous scalar signal nets, independent geometry and native-netlist checks, a reviewed PDF/preview, and a timestamped handover. Native ERC remains clean across all 301 existing pin assignments.
    [Z80_Simple_Computer.kicad_sch]
2026-11-09 Preserve Falken schematic cleanup and repair unintended connections
    Compare against 1184700 and archive the as-edited input and ERC/netlist evidence. Retain the human placement and label refinements, separate C22 supply from DTR_TTL, reconnect C24 to VS_MINUS, and reattach six serial labels. Recheck all 301 pin assignments, continuous signal paths and bus entries with zero ERC findings. Record human ownership, keep the generator overwrite guard, refresh previews, and document compact reminders for future sessions.
    [Z80_Simple_Computer.kicad_sch]
2026-11-09 Save collaboration transcript and PDF documentation exports
    Include the conversation from 261109-16 through its export request, retaining the requested +1 heading offset, plus the conversation and FreeRouting PDF exports. Ignore KiCad's nested local edit history while preserving it on disk.
2026-11-09 Add readable PSU schematic and FirstZ80 fixed-placement routing comparison
    [FirstZ80.dsn, FirstZ80.kicad_pcb, FirstZ80.kicad_sch, FirstZ80.raw.dsn, Z80_Simple_Computer.kicad_sch, before-hole-repair.kicad_pcb, before-tail-cleanup.kicad_pcb, placement.csv]
